wg1d/personal-autonomous-weather-station/README.md

# PAWS — Personal Autonomous Weather Station PAWS logo

Low-powered ESP32 IoT weather station — SD card logging, RTC timekeeping, direct Wi-Fi upload, phone-based fallback data gateway, time-series database, online dashboard and weather forecasting.

> 🌻 *And yes, that's a sunflower. A sunflower watches the sun. This weather station watches the weather. Close enough.*

## Documentation

Full design documentation (architecture, hardware, firmware, backend, ML) is available here: [personal-autonomous-weather-station](https://wg1d.github.io/personal-autonomous-weather-station/)

The API documentation of the firmware (`firmware/paws`), generated by Doxygen from the code comments, is published with it: [firmware API](https://wg1d.github.io/personal-autonomous-weather-station/api/)

## Development setup

All the tools (PlatformIO, Quarto, the C++ compiler, Doxygen, Python and the backend dependencies) are installed by [pixi](https://pixi.sh), with the exact versions frozen in `pixi.lock`. The CI uses the same environment, so a build that works locally works in the CI.

### 1. Install pixi

Follow the [official instructions](https://pixi.sh/latest/#installation). On Linux and macOS:

```bash
curl -fsSL https://pixi.sh/install.sh | sh
```

Then, from the root of the repository, install the environments (optional: `pixi run` also installs them on first use):

```bash
pixi install --all
```

### 2. Available commands

```bash
pixi run build-firmware   # build every PlatformIO project
pixi run test             # run the firmware tests on the computer
pixi run book             # generate the book in docs/_output
pixi run api-docs         # generate the firmware API docs in docs/_output/api
pixi run preview          # live preview of the book in the browser
pixi run dummy-server     # start the Phase 3 dummy backend server
pixi run test-server      # start the Phase 4 test server (upload v1)
pixi run backend          # start the backend on this computer (port 8080)
pixi run backend-demo     # the same, with 3 years of made-up data
pixi run backend-test     # run the backend tests
pixi run deploy-backend   # deploy the committed backend to the server
pixi run backup-backend   # make a backup of the data on the server now
pixi run restore-backend  # put back a backup on the server (optional: a day)
```

The first build downloads the ESP32 toolchain into `.pio-core/` (about 1.5 GB), inside the repository, so it does not interfere with an existing `~/.platformio`.

`pixi run api-docs` must run after `pixi run book`, since rendering the book empties `docs/_output`. It fails if a class, function or parameter of the firmware is not documented; the CI runs it on every pull request.

### 3. Flash the ESP32

Every PlatformIO command works through pixi. For example, to flash the current firmware and open the serial monitor:

```bash
pixi run pio run -d firmware/paws -t upload
pixi run pio device monitor -d firmware/paws
```

This builds the firmware of the station, with the periods of the design: one measurement every 15 minutes, one upload every hour. To see the whole cycle quickly on the bench, use the `esp32-bench` environment instead, which measures every minute and uploads every 5 minutes:

```bash
pixi run pio run -d firmware/paws -e esp32-bench -t upload
```

In VS Code with the PlatformIO extension, choose `env:esp32` or `env:esp32-bench` in the status bar.

The Proof of Concept sketches (`firmware/PoC/`) are flashed the same way, with their own folder after `-d`.

The Wi-Fi sketches read their credentials from a git-ignored `secrets.h`: copy `secrets.example.h` to `secrets.h` in the sketch folder and fill in your values. If `secrets.h` is missing, `pixi run build-firmware` creates it from the example, with placeholder values that only allow the sketch to compile.

### 4. Run the backend on the server

The backend (`backend/paws`) runs on a computer that stays on at home, as a systemd service named `paws-backend`, on port 8080. It is managed by [uv](https://docs.astral.sh/uv/), which must be installed on the server (`~/.local/bin/uv`), with SSH access from the development computer.

`pixi run deploy-backend` deploys the committed code to the SSH host `pi` (another host can be given: `bash scripts/deploy-backend.sh <host>`). It refuses to deploy changes that are not committed. On the server, the code lives in `~/paws/backend`, replaced at each deployment, and the data in `~/paws/data`, never touched by a deployment.

To stop the service, for example while the station is off, and keep it from starting again when the server boots:

```bash
ssh pi 'sudo systemctl disable --now paws-backend'
```

To start it again, now and at each boot:

```bash
ssh pi 'sudo systemctl enable --now paws-backend'
```

A deployment also starts the service, and enables it at boot. To check its state and read its messages:

```bash
ssh pi 'systemctl status paws-backend'
ssh pi 'journalctl -u paws-backend -n 50'
```

The station sends its data to the address set by `kServerUrl` in `firmware/paws/include/secrets.h`, for example `http://192.168.1.28:8080`.

### 5. Backups

Every night at 03:30, the timer `paws-backup.timer` copies the database and the log of the station, compressed, into `~/paws/data/backups` on the server, and to the cloud storage set by `PAWS_BACKUP_REMOTE` in `backend/paws/deploy/paws-backup.service` (`Proton:paws_backup` by default, a remote of [rclone](https://rclone.org/), which must be configured on the server). The last 7 days are kept on both sides. The Data tab of the dashboard shows the last backup, in red when it failed or is late.

```bash
pixi run backup-backend               # make a backup now
pixi run restore-backend              # put back the newest backup
pixi run restore-backend 2026-10-07   # put back the backup of a day
```

The restore takes the backup from the server, or from the cloud storage when the server no longer has it (a server installed again). The database it replaces is kept as `~/paws/data/measurements.db.before-restore`.

To start again from an empty database, for example to remove test data before the real station starts (this deletes the data on the server and its backups):

```bash
ssh pi 'sudo systemctl stop paws-backend && rm -f ~/paws/data/measurements.db ~/paws/data/station.log ~/paws/data/backups/* && sudo systemctl start paws-backend'
ssh pi 'rclone delete Proton:paws_backup'
```

### Environments

`pixi.toml` defines two environments:

- `default`: the development tools (PlatformIO, Quarto, C++ compiler, Doxygen);
- `backend`: Python and the backend dependencies. It is separate because PlatformIO requires an old version of `uvicorn` that recent FastAPI versions cannot use.

Each task runs in the right environment automatically.

### Not managed by pixi

Regenerating the wiring diagrams requires a LaTeX distribution with `circuitikz`, `latexmk` and `pdf2svg` (see `docs/assets/diagrams-src/Makefile`). This is only needed when a diagram changes.

## Roadmap

The primary goal of this project is to build a full, end-to-end **Proof of Concept (PoC)**, spanning from initial data collection (Phase 1) up through basic Machine Learning forecasting (Phase 6). Once this core foundation is proven, the remaining items are logged as optional future ideas to expand the station over time.

| Phase | Name | Key addition | Status |
|---|---|---|---|
| 1 | Core Functionality | Temp/pressure/humidity sensor + SD logging + RTC timekeeping | 🟢 Done |
| 2 | Power Management | ESP32 deep sleep + peripheral power cycling + RTC alarms | 🟢 Done |
| 3 | Wi-Fi & Data Transmission | ESP32 automated Wi-Fi push + phone-based gateway fallback | 🟢 Done |
| 4 | Firmware Architecture | State machine design + modular firmware rewrite with host tests | 🟢 Done |
| 5 | Backend MVP | SBC deployment + time-series database + online dashboard | 🟡 In progress |
| 6 | Forecasting — basic | LSTM on temp/pressure/humidity | ⬜ Planned |
| 7 | Sensors: BH1750 + VEML6075 | Light + UV sensors | 💭 Idea |
| 8 | Sensor: Soil moisture | Capacitive sensor | 💭 Idea |
| 9 | Sensor: Rain gauge | Tipping bucket | 💭 Idea |
| 10 | Sensor: Wind | Anemometer + wind vane | 💭 Idea |
| 11 | Model retrain + watering | Expanded LSTM + Random Forest watering model | 💭 Idea |
| 12 | Power: Solar + battery | Solar panel + battery monitoring | 💭 Idea |
| 13 | Stevenson screen + outdoor deployment | Final assembly into a Stevenson screen | 💭 Idea |

## Related projects

- [3D-PAWS](https://3dpaws.comet.ucar.edu/) (UCAR/COMET) — *3D-Printed Automatic Weather Station*: An open-source, low-cost weather station with 3D-printed sensor housings.

## License

MIT — see [LICENSE](LICENSE)
