wg1d/personal-autonomous-weather-station/docs/chapters/Architecture/Phase-04/00-3-data-and-upload.qmd

# Data and Upload {.unnumbered}

This chapter describes the row stored by `STORE` at each wake-up, and the protocol used by `UPLOAD` to send the rows to the server (see the [state machine](00-2-behavior.qmd#state-machine)).

## Data Format (v1)

Measurements are appended to `/measurements_v1.csv`, one row per wake-up:

```csv
timestamp,time_valid,temperature_c,humidity_pct,pressure_hpa
2026-10-01T14:15:00Z,1,18.42,62.10,1013.20
2026-10-01T14:30:00Z,1,18.37,,1013.18
```

| Column | Content | Unit |
|---|---|---|
| `timestamp` | Date and time of the measurement | ISO 8601, UTC, with the explicit `Z` suffix |
| `time_valid` | `1` if the clock was reliable when the row was written, `0` otherwise (F6 · Flag unreliable time) | — |
| `temperature_c` | Air temperature | degrees Celsius (°C) |
| `humidity_pct` | Relative humidity | percent (%) |
| `pressure_hpa` | Atmospheric pressure | hectopascals (hPa) |

The suffix of each measurement column gives its unit (`_c`, `_pct`, `_hpa`), so the file can be read without this table. The second row of the example shows a missing humidity value: an empty field.

A row is about 50 bytes: 96 rows per day represent about 5 KB per day, less than 2 MB per year.

When new sensors are added, the file format changes: the firmware then writes to a new file (`measurements_v2.csv`) with the new columns. A file never mixes two formats.

## Upload Protocol {#upload-protocol}

The PoC sent the whole CSV file at every upload, and the dummy server overwrote its copy each time. This protocol replaces it with three goals: send only the new rows, never lose data (N1), and survive an interruption at any moment. It is also the **contract with the Phase 5 backend**.

### The upload cursor

The station remembers where the server's copy ends with an **upload cursor**: the position, in bytes, of the first row of `/measurements_v1.csv` that the server has not acknowledged yet. It is stored in the small file `/upload.idx` on the SD card, so it survives power losses.

We use a position in bytes rather than a row number because the SD adapter can then jump directly to it (`file.seek()`), without reading the whole file. The cursor always points to the beginning of a row.

### Request

The station sends the rows after the cursor, preceded by the header line, so that each request is self-describing:

```http
POST /api/v1/measurements HTTP/1.1
Host: 192.168.1.15:8080
Content-Type: text/csv

timestamp,time_valid,temperature_c,humidity_pct,pressure_hpa
2026-10-01T13:15:00Z,1,18.20,63.40,1013.35
2026-10-01T13:30:00Z,1,18.31,62.90,1013.28
2026-10-01T13:45:00Z,1,18.35,62.50,1013.22
2026-10-01T14:00:00Z,1,18.40,62.20,1013.21
```

A request contains at most **500 rows** (about 25 KB). This bounds the duration of each request and the memory needed on the server. In normal operation, an upload contains 4 rows. After a week without Wi-Fi, the 672 missing rows are sent in two requests.

### Response

The server stores the rows and **ignores rows whose timestamp already exists**. It answers with a `2xx` status code and a short JSON summary:

```json
{"received": 4, "inserted": 4, "duplicates": 0}
```

The station only relies on the status code. The summary is printed on the serial port, which helps debugging.

### Sequence

```{mermaid}
sequenceDiagram
    participant S as Station
    participant SD as SD card
    participant B as Backend
    S->>SD: Read the cursor and the next rows (at most 500)
    S->>B: POST /api/v1/measurements (header + rows)
    B-->>S: 200 OK {"received": 500, ...}
    S->>SD: Move the cursor after the sent rows
    S->>SD: Read the next rows
    S->>B: POST /api/v1/measurements (header + rows)
    B-->>S: 200 OK {"received": 172, ...}
    S->>SD: Move the cursor after the sent rows
    Note over S,SD: No rows left: the upload is complete
```

### Failure cases

The protocol relies on two rules: **the cursor only moves forward after a `2xx` response**, and **the server accepts duplicates without error**. Together, they cover every interruption:

| What happens | Result |
|---|---|
| The Wi-Fi connection fails | Nothing is sent; the cursor does not move; retry at the next full hour. |
| The server answers with an error (not `2xx`) | The cursor does not move; the same rows are sent at the next upload. |
| The server stores the rows, but the response is lost (timeout, Wi-Fi drop) | The cursor does not move; the rows are sent again at the next upload, and the server ignores them as duplicates. |
| Power loss after the response, before the cursor is written | Same as a lost response: the rows are sent again and ignored. |
| `/upload.idx` is lost or unreadable | The cursor restarts at the beginning of the file: everything is sent again, and the server ignores the duplicates. |

In every case, the rows remain on the SD card, and the server never stores a row twice in its database. This property, where repeating a request has the same effect as sending it once, is called **idempotence**.

One case is not solved automatically: if the server keeps rejecting the same batch (for example because of a malformed row caused by a bug), the uploads are blocked. The data is still safe on the SD card, and the problem is visible on the dashboard, since no new data arrives.

### Scope

The protocol uses plain HTTP on the home network, without authentication, consistent with the single-user scope defined in [Motivation & Goals](../../01-motivation.qmd). It would need encryption (HTTPS) and authentication if the server were ever exposed to the internet.

The [next chapter](00-4-structure-and-verification.qmd) describes how the code is organized, and how we check that it meets the requirements.
