wg1d/personal-autonomous-weather-station/docs/index.qmd

# Introduction {.unnumbered}

PAWS logo

**PAWS** (*Personal Autonomous Weather Station*) is a low-powered ESP32 weather station with SD card logging, RTC timekeeping, direct Wi-Fi data transfer (and a phone-based data gateway as fallback), time-series database, online dashboard, plant watering decisions, and local weather forecasting on a Single-Board Computer like a Raspberry Pi.

It's a learning-oriented project covering several topics, such as:

- Embedded firmware based on Arduino code
- Weather data collection
- Solar-powered systems
- Data transfer & time-series databases
- Web dashboards
- Machine learning

::: {.callout-note}
**Related project — 3D-PAWS** (*3D-Printed Automatic Weather Station*, UCAR/COMET): an open-source initiative for low-cost weather stations using 3D-printed sensor housings. Their sensor designs (tipping bucket rain gauge, anemometer) are a useful reference for the DIY hardware phases of this project. See [3dpaws.comet.ucar.edu](https://3dpaws.comet.ucar.edu/).
:::

### Target Audience & Scope
> This project focuses on system integration, software architecture, and power management. It is **not** a beginner tutorial on how to install the Arduino IDE, how to solder, or how to write basic ESP32 blink sketches. It assumes you already know how to compile and upload code to an ESP32.

### Resources for Beginners
If you are new to the ESP32 ecosystem, we recommend reading the following tutorials before starting this weather station:

- **[uPesy Documentation](https://www.upesy.fr/blogs/tutorials/esp32-tutorials-for-arduino-code-and-micropython)**: clear, well-illustrated tutorials covering most ESP32 topics.
- **[Random Nerd Tutorials](https://randomnerdtutorials.com/)**: a large collection of beginner-friendly ESP32 projects and electronics guides.

---

## How to read this document

| Goal | Chapter |
|---|---|
| Understand *why* this project exists | [Motivation & Goals](chapters/01-motivation.qmd) |
| Understand *how* the project evolves | [Roadmap](chapters/02-roadmap.qmd) |
| Start building the prototype | [Start Building Now 🚀](chapters/PoC/Phase-01/01-components.qmd)|

---
