wg1d/personal-autonomous-weather-station/docs/chapters/02-roadmap.qmd

# Roadmap {.unnumbered}

Building a weather station from scratch can be overwhelming. To keep the learning curve manageable, this project is divided into two journeys: the **Proof of Concept (PoC)**, which builds each feature with simple sketches, and the **Production Architecture**, which rebuilds the firmware on a clean, tested structure.

## Journey 1: The Proof of Concept (Phases 1-3)

The goal of the PoC is to get every feature working as simply as possible, to understand how the hardware behaves. We write plain `.ino` sketches, adding one feature at a time. By the end of this journey, you will have a working weather station that reads sensors, sleeps, and uploads data over Wi-Fi, without any advanced C++.

*   **Phase 1: Core Functionality**
    We start with a breadboard and a USB cable. We will wire the ESP32 to a temperature/humidity sensor, an SD card, and an RTC, writing simple scripts to log data.
*   **Phase 2: Power Management**
    Once the baseline works, we introduce ESP32 deep sleep and RTC alarms, the foundation for running on batteries.
*   **Phase 3: Wi-Fi & Data Transmission**
    Finally, we connect the station to Wi-Fi to push data to a local dummy server, add a manual download fallback, and synchronize the clock with NTP. This completes the end-to-end PoC.

## Journey 2: The Production Architecture (Phase 4)

Once you understand *how* the hardware works from the PoC, we rebuild the firmware properly. Experienced developers can start directly with this phase, but the PoC chapters remain the reference for wiring and hardware behavior.

*   **Phase 4: Modular Architecture**
    The PoC sketches grew into long, monolithic files that are hard to test and extend. We design the architecture on paper first (requirements, state machine, module interfaces, data format), then rebuild the firmware from scratch as a single PlatformIO project, step by step, with unit tests running on the host computer.

## Beyond Firmware (Phases 5+)

Once the production firmware is reliable, we shift our focus away from the ESP32.

*   **Phase 5: Backend MVP**
    We deploy a server on a small computer that stays on at home, with a database, a dashboard and a daily backup, to replace our test server.
*   **Phase 6: Outdoor Station**
    The station leaves the breadboard and the desk: a soldered board, a weatherproof enclosure, a radiation shield (a Stevenson screen) so that the sun does not heat the sensor, a Wi-Fi link that reaches the garden, and its own power: a battery charged by a small solar panel, since there is no socket outdoors, with its charge measured and sent with the data.
*   **Phase 7: Data Collection**
    The station runs outdoors for months. We watch how reliable it is: its power through the seasons, short winter days included, the failures, the values that make no sense.
*   **Phase 8: Basic Forecasting**
    With months of real measurements, we introduce basic Machine Learning (LSTM) to predict weather trends. A forecast can only learn from the data it is given: this is why the station goes outdoors first.

---

# Future Expansions (Ideas) {.unnumbered}

While Phases 1 through 8 represent the core project (from data collection to forecasting), the following sections are purely optional ideas to expand the station's capabilities if we decide to take it further.

## A Single Definition of the Data Format (Idea)
The CSV format of the measurements is written twice: in C++ in the firmware, which writes the rows, and in Python in the backend, which reads them. A single reference file could describe the columns (name, type, unit), and a small script could generate the code of both sides from it, so that they can never disagree. This becomes more useful as new sensors add columns to the format.

## Adding Light & UV Sensors (Idea)
Once we validate that the system is working fine (data acquisition, storage, data transfer, and basic ML), let's improve the station by adding some new sensors. Let's start by adding a light and UV sensor to the station like the BH1750 and the VEML6075.

## Adding Soil Moisture Sensor (Idea)
After that, we can add a soil moisture sensor (such as the ubiquitous Capacitive Soil Moisture Sensor v1.2 or v2.0) to the station in order to determine if plants need to be watered.

## Adding a Rain Gauge (Idea)
Adding a tipping bucket rain gauge sensor to measure rainfall would be a good improvement to the station. The 3D-PAWS project has a good example of a 3D-printed tipping bucket rain gauge.

## Adding an Anemometer (Idea)
Adding an anemometer and wind vane to measure wind speed and direction would be a good addition to the station. The 3D-PAWS project also has a good example of a 3D-printed anemometer and wind vane.

## Advanced ML & Watering (Idea)
With all sensors active, we will retrain our ML models and add a Random Forest model specifically to optimize the watering schedule of the plants based on the new local data.
