wg1d/personal-autonomous-weather-station/docs/chapters/01-motivation.qmd

# Motivation & Goals {.unnumbered}

---

## What this project is really about

This is a **personal learning project** with a clear, hands-on goal: understand how a weather station works end-to-end, from raw sensor reading to a usable dashboard and simple predictive models.

The motivating use case is intentionally concrete and minimalistic:

> *Knowing when it actually makes sense to water outdoor plants, based on observed local conditions.*

The project is **not** intended to compete with commercial stations, replace a professional meteorological network, or solve large-scale climate problems. It is intended to be educational, achievable, and progressively useful.

---

## Goals

The project has three layers of goals, ordered by priority:

### Layer 1 — Hardware & firmware (core)

- Build a reliable, low-power data logger from scratch
- Understand sensor data acquisition, embedded timekeeping, and deep-sleep power management of an ESP32 microcontroller
- Produce consistent, timestamped, locally-stored data

### Layer 2 — Data pipeline

- Understand how to move data from a field device with intermittent Wi-Fi access to a server
- Build a simple backend (ingestion, storage, dashboard) hosted locally on a Raspberry Pi

### Layer 3 — Local intelligence

- Use collected data for practical decisions (plant watering)
- Explore short-term weather forecasting using machine learning on local sensor data

---

## Scope and constraints

The project explicitly accepts the following constraints:

| Constraint | Rationale |
|---|---|
| Single station | Manageable scope for a personal project |
| Single user | No multi-user, permissions, or security requirements |
| No permanent internet connection at the station | Enables solar/battery operation, the station connects to Wi-Fi only to upload data, remaining offline during measurement and deep sleep |
| Incremental approach | Each phase must be independently useful |

---

## Day-to-day operation

In typical operation, data transmission would be fully automated. However, a local fallback mode will be developed for offline environments or testing purposes (manual data transfer using a phone as gateway):

1. **Automated Upload (Primary)**: The station wakes up on its schedule, reads the sensors, appends the data to the local SD card, and attempts to connect to the home Wi-Fi network. If successful, it uploads the latest readings directly to the server API and returns to deep sleep. If the home Wi-Fi is out of range or unavailable, it directly goes to deep sleep, leaving the data safely buffered on the SD card.
2. **Manual Download Gateway (Fallback)**: When deployed out of range (or for testing purposes), the user can press a button. This wakes the ESP32 and puts it in `SERVER` mode, spinning up a local Wi-Fi Access Point for 3 minutes. The user connects their phone, downloads the data via a browser, and later uploads it to the backend server. The station automatically returns to deep sleep after the 3-minute timeout.

---

## Build philosophy

Each phase of this project must be **independently useful**: you can stop at any phase and have a working system. The hardware built in one phase is reused in the next ones. The PoC firmware is a learning step: it is deliberately rewritten in Phase 4, once we understand the hardware well enough to design a clean architecture.

---

## What this project is NOT

- A commercial product
- A real-time alerting system
- A replacement for a professional weather API
- A multi-node sensor network

These are all compatible with the architecture but are explicitly out of scope.
