wg1d/personal-autonomous-weather-station/docs/chapters/03-prototyping.qmd

# Incremental Prototyping Guide {.unnumbered}

To ensure a robust and debuggable build, the station is developed **incrementally**. Instead of building the entire system at once, you will assemble and validate it step-by-step on a breadboard. This approach makes it easy to isolate hardware defects (like bad jumper wires or faulty modules) from software bugs.

This chapter walks through the **8 prototyping milestones**. Each milestone includes the necessary wiring diagrams in ASCII, links to the complete Arduino example code, and instructions for verifying that it works.

---

## ESP32 Breadboard Pin Mapping

To ensure you can reuse your existing breadboard configuration without rewiring, we align all code with the pin connections established in your project:

| Module / Component | ESP32 Pin | Function | Description |
| :--- | :--- | :--- | :--- |
| **DS3231 RTC** | GPIO 21 | `SDA` (I²C Data) | Shared I²C communication line |
| | GPIO 22 | `SCL` (I²C Clock) | Shared I²C clock line |
| | **GPIO 36** (`VP`) | `SQW / INT` | RTC Alarm output; wakes ESP32 from sleep via `EXT0` |
| **BME280 Sensor** | GPIO 21 | `SDA` (I²C Data) | Shared I²C communication line |
| | GPIO 22 | `SCL` (I²C Clock) | Shared I²C clock line |
| **SD Card Reader** | GPIO 5 | `CS` (Chip Select) | Dedicated SPI Select line |
| | GPIO 18 | `SCK` (Serial Clock) | Shared SPI Clock line |
| | GPIO 19 | `MISO` | Shared SPI Master In Slave Out line |
| | GPIO 23 | `MOSI` | Shared SPI Master Out Slave In line |
| | **GPIO 13** | `Power Gate` | Controlled VCC supply to cut power to the SD reader during sleep |
| **Manual Button** | **GPIO 39** (`VN`) | `Switch Trigger` | Manual trigger for AP mode; wakes ESP32 via `EXT1` |

---

## Step 1: Button & LED (Pull-Up/Pull-Down Resistor Physics)

The first step is to verify digital inputs/outputs and understand the physical properties of input pins. 

### The Physics: Floating Pins & Pull-Up Resistors
When an ESP32 GPIO pin is configured as an input, it is in a "high-impedance" state. If it is not connected to a reference voltage, it is **floating**. Electromagnetic noise from the air or nearby AC lines will cause the pin to randomly fluctuate between `HIGH` (3.3V) and `LOW` (0V).

To prevent this, we connect the input pin to a known voltage level using a resistor:
*   **Pull-Up Resistor (Active-Low):** Connects the input pin to `3.3V`. The pin reads `HIGH` by default. Pressing the button connects the pin to `GND`, making it read `LOW`.
*   **Pull-Down Resistor (Active-High):** Connects the input pin to `GND`. The pin reads `LOW` by default. Pressing the button connects the pin to `3.3V`, making it read `HIGH`.

Active-low (using pull-up resistors) is the industry standard for microcontrollers. If a ground wire shorts to a metal frame, it's harmless; if a VCC wire shorts, it causes a short circuit.

::: {.callout-note}
### Can I just use the ESP32's internal pull-up resistors?
Yes! The ESP32 actually does allow you to enable its internal pull-up/pull-down resistors during deep sleep, provided you use the RTC-specific control functions (e.g., `rtc_gpio_pullup_en(GPIO_NUM_39)`). If you do this, you can omit the external resistor from your breadboard.

However, using a **physical external resistor** (like the $10\text{ k}\Omega$ or $100\text{ k}\Omega$ you set up) remains the recommended best practice for two main reasons:
* **Lower Power Consumption:** The internal RTC resistors are fixed at roughly $45\text{ k}\Omega$. While a button is pressed, the current flowing to GND is $3.3\text{V} / 45\text{ k}\Omega = 73\text{ }\mu\text{A}$. If you use a physical external $100\text{ k}\Omega$ pull-up resistor, this current is cut in half to just $33\text{ }\mu\text{A}$.
* **Noise Immunity & Stability:** Internal resistors are transistor-based and can drift with temperature and manufacturing tolerances. Physical discrete resistors are highly stable and far more effective at preventing false wakeups caused by electromagnetic noise in long sensor wires.
:::

#### The Resistor Equation
The value of the resistor $R$ must be selected such that when the switch is open, the voltage at the input pin ($V_{pin}$) remains well within the threshold for a stable logic state, despite the tiny input leakage current ($I_{leak}$) flowing into or out of the pin.

For a pull-up resistor:
$$V_{pin} = V_{dd} - (I_{leak} \times R)$$

To guarantee the ESP32 registers a logic `HIGH`, $V_{pin}$ must stay above the minimum high-level input voltage ($V_{IH}$). For the ESP32 running at $V_{dd} = 3.3\text{V}$, $V_{IH} = 0.75 \times V_{dd} = 2.475\text{V}$. The input leakage current is typically $I_{leak} = 1\text{ }\mu\text{A}$ maximum.

Rearranging the formula to solve for the maximum allowable resistance $R_{pu}$:
$$R_{pu} \le \frac{V_{dd} - V_{IH}}{I_{leak}}$$
$$R_{pu} \le \frac{3.3\text{V} - 2.475\text{V}}{10^{-6}\text{A}} = 825\text{ k}\Omega$$

While any resistor under $825\text{ k}\Omega$ works in theory, standard practice is to use a **$10\text{ k}\Omega$** or **$47\text{ k}\Omega$** resistor. 
*   **Why not use the maximum ($825\text{ k}\Omega$)?** High resistance leaves the pin susceptible to electromagnetic interference (noise), which can cause false wakeups.
*   **Why not use very low resistance (e.g. $1\text{ k}\Omega$)?** When the button is pressed, a current path is created from $V_{dd}$ to `GND`. The current is $I = V_{dd} / R$. A $1\text{ k}\Omega$ resistor draws $3.3\text{ mA}$ while pressed. A $10\text{ k}\Omega$ resistor drops that draw to $0.33\text{ mA}$ ($330\text{ }\mu\text{A}$), protecting the battery during manual button presses.

### Wiring Schematic (ASCII)

```
             +3.3V (VCC)
                 |
               [10k Ohm Resistor]
                 |
  GPIO 39 -------+------[ Button ]------ GND
  
  GPIO 2  -------[ LED ]---[ 220 Ohm ]-- GND
```

### Prototyping Code
The code for this step is located in [01_button_led.ino](file:///home/william/Documents/personal-autonomous-weather-station/firmware/prototyping/01_button_led/01_button_led.ino). It polls the button on GPIO 39 and reflects the state on the blue onboard LED (GPIO 2).

### Verification
1. Upload [01_button_led.ino](file:///home/william/Documents/personal-autonomous-weather-station/firmware/prototyping/01_button_led/01_button_led.ino).
2. Open the Serial Monitor at `115200` baud.
3. Verify that pressing the button logs `Button Pressed (LOW) -> LED ON` and lights the blue LED.
4. Releasing the button logs `Button Released (HIGH) -> LED OFF` and turns off the LED.

---

## Step 2: Button Wakeup (Deep Sleep & EXT1)

To run on batteries, the ESP32 must spend most of its time in **Deep Sleep**. In this mode, the main CPU and RAM are powered down. Only the ultra-low-power RTC (Real-Time Clock) controller remains active.

### Concept: State Retention & EXT1 Wakeup
Since main RAM is cleared when the ESP32 sleeps, **every wakeup is a fresh boot**. To preserve variables (such as a boot counter) across sleep cycles, we use the `RTC_DATA_ATTR` modifier. This forces the compiler to place the variable in the RTC's slow memory.

To wake up the ESP32 via a button press, we configure the **`EXT1`** wakeup controller. `EXT1` monitors a list of pins and triggers a boot when they go `LOW` (active-low configuration).

### Wiring Schematic (ASCII)
Same as Step 1 (the button connects GPIO 39 to GND via a pull-up resistor).

### Prototyping Code
The code is located in [02_button_wakeup.ino](file:///home/william/Documents/personal-autonomous-weather-station/firmware/prototyping/02_button_wakeup/02_button_wakeup.ino).

### Verification
1. Upload [02_button_wakeup.ino](file:///home/william/Documents/personal-autonomous-weather-station/firmware/prototyping/02_button_wakeup/02_button_wakeup.ino).
2. Open the Serial Monitor. Press `EN` (Reset) on the board. You should see `Boot number: 1` and `Wakeup not caused by deep sleep`.
3. The board goes to sleep and the LED turns off.
4. Press the button. The ESP32 boots instantly, turns on the LED for 2 seconds, and prints:
   * `Boot number: 2`
   * `Wakeup caused by external signal using RTC_CNTL (EXT1 - Button on GPIO 39)`

---

## Step 3: Temperature/Humidity/Pressure Sensor (BME280)

We introduce the **BME280** sensor to read environmental conditions over the **I²C** bus.

### Concept: The I²C Bus
The I²C bus uses only two shared wires to talk to multiple devices:
*   **SDA (Serial Data Line):** Carries the data.
*   **SCL (Serial Clock Line):** Synchronizes the data transfer.

During Deep Sleep, the BME280 sensor enters standby automatically when the ESP32 stops communication. In this standby mode, it draws a negligible current of **0.1 µA**, meaning it does not need physical power gating.

### Wiring Schematic (ASCII)

```
                 ESP32
             +-----------+
             |           |
             |  GPIO 21  |<====> SDA (BME280 SDA)
             |  GPIO 22  |=====> SCL (BME280 SCL)
             |  3.3V     |-----> VCC (BME280 VCC)
             |  GND      |-----> GND (BME280 GND)
             +-----------+
```

### Prototyping Code
The code is located in [03_temp_humidity_sensor.ino](file:///home/william/Documents/personal-autonomous-weather-station/firmware/prototyping/03_temp_humidity_sensor/03_temp_humidity_sensor.ino).

### Verification
1. Upload [03_temp_humidity_sensor.ino](file:///home/william/Documents/personal-autonomous-weather-station/firmware/prototyping/03_temp_humidity_sensor/03_temp_humidity_sensor.ino).
2. The Serial Monitor will print environmental values every 5 seconds.
3. Blow gently on the sensor to confirm that the humidity and temperature readings update dynamically.

---

## Step 4: Real-Time Clock & Alarms (DS3231)

To wake up the station periodically (e.g. every 10 minutes) at exact intervals, we use a temperature-compensated **DS3231 RTC**.

### Concept: EXT0 Wakeup
The DS3231 maintains accurate time and can trigger its `SQW/INT` alarm pin. 
*   We connect this pin to **GPIO 36** on the ESP32.
*   The SQW pin is active-low (goes to 0V when an alarm fires).
*   Since GPIO 36 is an input-only pin without internal pull-ups, we must connect a physical **10k Ohm external pull-up** resistor between GPIO 36 and 3.3V.
*   We configure the ESP32 to wake up on **`EXT0`** (which monitors a single RTC pin and wakes the chip when the pin goes `LOW`).

### Wiring Schematic (ASCII)

```
                   +3.3V (VCC)
                       |
                     [10k Ohm]
                       |
  GPIO 36 -------------+------------ SQW/INT (DS3231)
  
  GPIO 21 <========================> SDA (DS3231 SDA) [Shared I2C]
  GPIO 22 =========================> SCL (DS3231 SCL) [Shared I2C]
```

### Prototyping Code
The code is located in [04_real_time_clock.ino](file:///home/william/Documents/personal-autonomous-weather-station/firmware/prototyping/04_real_time_clock/04_real_time_clock.ino).

### Verification
1. Upload [04_real_time_clock.ino](file:///home/william/Documents/personal-autonomous-weather-station/firmware/prototyping/04_real_time_clock/04_real_time_clock.ino).
2. The ESP32 sets the alarm to trigger at the beginning of the next minute and goes to sleep.
3. When the RTC alarm fires, the ESP32 boots and reports `Wakeup caused by external RTC Alarm (EXT0 on GPIO 36)`.

---

## Step 5: SD Card CSV Logger & Power Gating

Writing measurements to an SD card is critical for data buffering. However, SD card modules draw up to **2 mA** when idle, which would deplete the battery in a few weeks.

### Concept: Power Gating
To eliminate standby current, we connect the SD card reader's power line (`VCC`) to **GPIO 13** (acting as a high-side switch). 
*   **Active State:** We drive GPIO 13 `HIGH` to supply 3.3V to the reader, wait 100ms for voltage stability, and initialize the card.
*   **Sleep State:** We unmount the SD card via software (`SD.end()`) and drive GPIO 13 `LOW` to cut off power completely before entering deep sleep.

### Wiring Schematic (ASCII)

```
             ESP32
         +-----------+
         |  GPIO 13  |----------> VCC (SD Card VCC) [Power Gate]
         |  GPIO 5   |----------> CS  (SD Card Chip Select)
         |  GPIO 23  |----------> MOSI (SD Card MOSI)
         |  GPIO 19  |<---------- MISO (SD Card MISO)
         |  GPIO 18  |----------> SCK  (SD Card Clock)
         |  GND      |----------> GND  (SD Card GND)
         +-----------+
```

### Prototyping Code
The code is located in [05_sd_card_logger.ino](file:///home/william/Documents/personal-autonomous-weather-station/firmware/prototyping/05_sd_card_logger/05_sd_card_logger.ino).

### Verification
1. Insert a FAT32-formatted MicroSD card into the reader.
2. Upload [05_sd_card_logger.ino](file:///home/william/Documents/personal-autonomous-weather-station/firmware/prototyping/05_sd_card_logger/05_sd_card_logger.ino).
3. The Serial Monitor should show that the SD card powers up, mounts, appends a mock CSV line, displays the total file content, and powers off.
4. The ESP32 sleeps for 10 seconds and repeats the cycle.

---

## Step 6: Integrated Offline Datalogger

We now integrate all the previous components into a single offline datalogger loop.

### Operations Flow
```
        [ Boot / Wakeup ]
                |
     Determine Wakeup Cause
      /                  \
   (RTC)               (Button)
    /                      \
Read BME280 Sensors     Read BME280 Sensors
    \                      /
   Power Gate ON SD Card
   Append Log to data.csv
   Power Gate OFF SD Card
                |
     Schedule next RTC Alarm
   Enable EXT0 (RTC) & EXT1 (Button)
                |
        [ Deep Sleep ]
```

### Prototyping Code
The code is located in [06_full_datalogger.ino](file:///home/william/Documents/personal-autonomous-weather-station/firmware/prototyping/06_full_datalogger/06_full_datalogger.ino).

### Verification
1. Upload [06_full_datalogger.ino](file:///home/william/Documents/personal-autonomous-weather-station/firmware/prototyping/06_full_datalogger/06_full_datalogger.ino).
2. The board logs readings to `/data.csv` every minute.
3. Pressing the manual button at any time will trigger an immediate measurement cycle.

---

## Step 7: Wi-Fi Access Point & Server Mode

When the weather station is deployed outdoors, we need a wireless method to download the CSV data.

### Concept: Manual AP Activation
If the ESP32 is woken up by the manual button (detected via `EXT1`), it enters AP Mode instead of taking a periodic reading.
*   It spins up an Access Point called `PAWS-Station` with password `password123`.
*   It starts an HTTP Web Server on port 80.
*   The web page displays a list of files on the SD card with download links.
*   A **3-minute inactivity timer** is tracked. If the user does not query the server, the ESP32 automatically shuts down the AP, powers off the SD card, and goes back to deep sleep to protect the battery.

### Prototyping Code
The code is located in [07_wifi_ap.ino](file:///home/william/Documents/personal-autonomous-weather-station/firmware/prototyping/07_wifi_ap/07_wifi_ap.ino).

### Verification
1. Upload [07_wifi_ap.ino](file:///home/william/Documents/personal-autonomous-weather-station/firmware/prototyping/07_wifi_ap/07_wifi_ap.ino).
2. Connect your phone or PC to the `PAWS-Station` Wi-Fi network.
3. Open a browser and navigate to `http://192.168.4.1`.
4. Click on `data.csv` to download the logged data directly to your device.
5. Wait 3 minutes without action; the station should print `Inactivity timeout reached` and go to sleep.

---

## Step 8: Wi-Fi Client & Linux Server Integration

Finally, we test automatic synchronization where the ESP32 acts as a client that connects to your home network and uploads the data to your Linux host.

### Concept: Automated Upload
*   The ESP32 connects to your home Wi-Fi.
*   It reads the raw contents of `/data.csv` from the SD card.
*   It issues an HTTP `POST` request to `http://<LINUX_IP>:8000/api/upload`.
*   A simple Python script runs on the Linux host to save the incoming CSV stream.

### 1. Python Server Script (Linux Host)
Save this script as `server.py` on your Linux host and execute it:
```python
import http.server
import socketserver
import os

PORT = 8000
LOG_FILE = "paws_log_sink.csv"

class DataSinkHandler(http.server.SimpleHTTPRequestHandler):
    def do_POST(self):
        if self.path == "/api/upload":
            length = int(self.headers['Content-Length'])
            raw_data = self.rfile.read(length)
            
            print(f"\n[+] Incoming upload of {length} bytes received.")
            try:
                decoded = raw_data.decode('utf-8')
                with open(LOG_FILE, "w") as f:
                    f.write(decoded)
                print(f"[+] Saved successfully to: {os.path.abspath(LOG_FILE)}")
                
                self.send_response(200)
                self.send_header('Content-Type', 'text/plain')
                self.end_headers()
                self.wfile.write(b"Success")
            except Exception as e:
                print(f"[-] Write error: {e}")
                self.send_response(500)
                self.end_headers()
        else:
            self.send_response(404)
            self.end_headers()

if __name__ == "__main__":
    with socketserver.TCPServer(("", PORT), DataSinkHandler) as server:
        print(f"[*] Linux Receiver online on port {PORT}...")
        try:
            server.serve_forever()
        except KeyboardInterrupt:
            print("\n[-] Server closed.")
```

### Prototyping Code
The code is located in [08_wifi_client.ino](file:///home/william/Documents/personal-autonomous-weather-station/firmware/prototyping/08_wifi_client/08_wifi_client.ino). Make sure to configure the `ssid`, `password`, and `serverIP` variables inside the code before uploading.

### Verification
1. Run `python3 server.py` on your Linux terminal.
2. Edit the Wi-Fi credentials and local Linux IP in [08_wifi_client.ino](file:///home/william/Documents/personal-autonomous-weather-station/firmware/prototyping/08_wifi_client/08_wifi_client.ino) and upload it.
3. Check the Python terminal on the Linux host; it should print `Incoming upload of X bytes received` and create the `paws_log_sink.csv` file.
