wg1d/personal-autonomous-weather-station/docs/chapters/Appendix/01-pull-resistors.qmd

# Pull-Up and Pull-Down Resistors {.unnumbered}

A button, an alarm output or an enable pin is connected to an input of the microcontroller through a resistor that gives the input a defined state when nothing drives it. This appendix explains the two ways to connect this resistor, computes what happens in each case, and gives the rules to choose between them. The [Hardware Changes](../PoC/Phase-02/02-hardware-modifications.qmd) and [Fallback AP](../PoC/Phase-03/03-fallback-ap.qmd) chapters apply them.

## A floating pin
A pin that is not connected to anything is "floating": it picks up electrical noise and randomly reads `HIGH` (1) or `LOW` (0). A resistor gives the pin a defined default state when the button is not pressed:

- **Pull-up Resistor:** connects the pin to `3.3V`. The default state is `HIGH`; pressing the button connects the pin to `GND`, driving it `LOW`.
- **Pull-down Resistor:** connects the pin to `GND`. The default state is `LOW`; pressing the button connects the pin to `3.3V`, driving it `HIGH`.

::: {layout-ncol=2}
Pull-up, button released: the pin reads HIGH

Pull-up, button pressed: the pin reads LOW

Pull-down, button released: the pin reads LOW

Pull-down, button pressed: the pin reads HIGH
:::

In both cases, no current flows through the resistor while the button is released, since both ends are at the same voltage. The consumption during deep sleep is therefore the same.

## The Equations Behind the Diagrams
The button and the resistor are connected **in series** between 3.3V and GND. An ESP32 input draws almost no current (at most 50 nA according to the ESP32 datasheet), so the same current $I$ flows through the button and the resistor. Two laws are enough to compute everything:

- **Ohm's law** for the resistor: $U_R = R \times I$
- **The voltages add up** along the series path: $V_{CC} = U_R + U_{button}$

**Button released (open).** No current can flow through an open contact:

$$I = 0 \quad\Rightarrow\quad U_R = R \times 0 = 0\,V$$

- Pull-up: the pin sees $V_{CC}$ through the resistor, $V_{in} = V_{CC} - U_R = 3.3\,V$: logic **HIGH**.
- Pull-down: the pin sees GND through the resistor, $V_{in} = U_R = 0\,V$: logic **LOW**.

**Button pressed (closed).** The closed contact has almost no resistance, so it connects the pin directly to GND (pull-up) or to $V_{CC}$ (pull-down). All the voltage is then across the resistor:

$$U_R = V_{CC} = 3.3\,V \qquad I = \frac{V_{CC}}{R} = \frac{3.3\,V}{10\,k\Omega} = 0.33\,mA$$

- Pull-up: $V_{in} = 0\,V$: logic **LOW**.
- Pull-down: $V_{in} = V_{CC} = 3.3\,V$: logic **HIGH**.

**The leakage current sets the maximum resistance.** In reality, the pin draws a tiny current $I_{leak}$ (up to 50 nA). With a pull-up and the button released, this current flows through the resistor and lowers the pin voltage:

$$V_{in} = V_{CC} - R \times I_{leak}$$

With 10kΩ, the drop is only $10\,k\Omega \times 50\,nA = 0.5\,mV$. The pin is read as HIGH as long as $V_{in}$ stays above $V_{IH} = 0.75 \times V_{CC} = 2.475\,V$ (ESP32 datasheet), which gives an upper limit for $R$:

$$R_{max} = \frac{V_{CC} - V_{IH}}{I_{leak}} = \frac{3.3\,V - 2.475\,V}{50\,nA} \approx 16\,M\Omega$$

The same reasoning applies to a pull-down, with the LOW threshold $V_{IL} = 0.25 \times V_{CC}$. This theoretical limit is very high: in practice, a very large resistor also lets electrical noise move the pin voltage, which is why values between 10kΩ and 100kΩ are used. For comparison, the ESP32 internal pull-up and pull-down resistors are about 45kΩ (not available on GPIOs 34 to 39).

## Which One to Choose?
Both configurations work electrically. The choice depends on three questions, in this order:

1. **What can the other side of the line do?** Many chip outputs are *open-drain*: they can only pull the line LOW, never drive it HIGH. This is the case of the I2C bus and of the DS3231 `SQW` pin. For these signals there is no choice: a **pull-up** is mandatory.
2. **What must happen when the microcontroller does not drive the pin?** During a reset, while the firmware starts, or in deep sleep, the ESP32 pins are not driven. The resistor then sets the state of the line, and this state must be the safe one. For an enable pin that switches something on (like the SD card `OFF` pin, or the gate of a transistor that powers a module), the safe state is "off": a **pull-down** keeps the module off until the firmware decides otherwise.
3. **What does the input require?** Some inputs only react to one level. On the ESP32, `EXT1` can wake the chip when *any* pin goes HIGH, but not when *any* pin goes LOW. Internal resistors also matter: most microcontrollers have internal pull-ups, but not all have internal pull-downs, and the ESP32 GPIOs 34 to 39 have neither.

When none of these constraints applies, **pull-up with active-low** is the most common convention for buttons. One reason is safety with long wires: with a pull-up, the wire going to the button carries GND, and touching a grounded metal part is harmless. With a pull-down, that wire carries 3.3V, and touching a grounded part short-circuits the supply.

Here is how these rules apply to the station of the proof of concept, in the [Fallback AP](../PoC/Phase-03/03-fallback-ap.qmd) chapter:

| Signal | Resistor | Deciding rule |
|---|---|---|
| DS3231 `SQW` (GPIO 36) | Pull-up | Open-drain output (rule 1) |
| SD card `OFF` (GPIO 13) | Pull-down | Module off by default (rule 2) |
| Fallback button (GPIO 39) | Pull-down | Wake-up with `EXT1` on HIGH (rule 3) |

For the button, the drawback of a 3.3V wire is accepted, because the button sits a few centimeters from the board.
