wg1d/personal-autonomous-weather-station/docs/assets/diagrams-src/common.tex

\documentclass[border = 1mm]{standalone}
\usepackage[utf8]{inputenc}
\usepackage{siunitx}
\usepackage[european, straightvoltages, RPvoltages]{circuitikz}
\usetikzlibrary{babel}
\input{DS3231.tex}
\input{BME280.tex}
\input{uPesy_SDCard.tex}
\input{uPesy_ESP32.tex}
