wg1d/personal-autonomous-weather-station/docs/chapters/PoC/Phase-03/02-dummy-backend.qmd

# Dummy Backend Server {.unnumbered}

To verify that the ESP32 transmits its data over Wi-Fi, we need something on the other end to receive it.

Eventually, we will build a real backend on a Single-Board Computer (SBC) such as a Raspberry Pi, with a time-series database. For now, that would distract us from validating the firmware.

Instead, we build a minimal "dummy" backend in Python using **FastAPI**. It takes about 25 lines of code and runs on your computer to prove that the connection works.

## The Code

> **Ready-to-use project:** The complete code for this dummy server is available in the repository here: [`dummy_server`](https://github.com/wg1d/personal-autonomous-weather-station/tree/main/backend/Phase-03/dummy_server)

The project's [pixi](https://pixi.sh) environment already includes Python, FastAPI and uvicorn, with the versions frozen in `pixi.lock` (see the repository README). To start the server, open a terminal at the root of the repository and run:

```bash
pixi run dummy-server
```

Without pixi, any Python 3.12 environment works: install the two dependencies with `pip install fastapi "uvicorn[standard]"`, then run `python main.py` from the `backend/Phase-03/dummy_server` folder.

## The Server Code

For reference, the entire server is about 25 lines of code:

```{.python include="../../../../backend/Phase-03/dummy_server/main.py"}
```

## Running the Test

1. Ensure your server is running (`pixi run dummy-server`).
2. You will see a message indicating the server is running on `http://0.0.0.0:5000`.
3. Power on your ESP32.
4. Watch the Python terminal: at the next wake-up, the server logs the size of the received data, and a `received_data.csv` file appears in the folder. Each upload overwrites this file, which is fine since the ESP32 always sends the whole CSV.

### Expected Output

If everything works, you should see the following logs on both devices.

**ESP32 Serial Monitor:**
```text
--- Waking up from Deep Sleep ---
Wakeup by external signal using RTC_IO (RTC Alarm)
Data: 2026-07-23T17:21:00,29.72,29.94,992.06
Data saved to SD card.
Connecting to WiFi....
Connected to WiFi network
Uploading CSV file to server: http://192.168.1.15:5000/upload
HTTP Response code: 200
Next reading scheduled for: 17:21:30
Entering Deep Sleep...
```

**Python Dummy Server Terminal:**
```text
--- Received 1250 bytes of CSV data! ---
Successfully saved to received_data.csv
---------------------------------------------
INFO:     192.168.1.35:60951 - "POST /upload HTTP/1.1" 200 OK
```

## Next Steps

The ESP32 now transmits its readings over the local Wi-Fi: the end-to-end data path works. But what if the station is out of Wi-Fi range? How do you get the data?

In the next chapter, we build a fallback mechanism: a push-button that makes the ESP32 broadcast its *own* Wi-Fi network, so you can download the data with your phone.
