wg1d/personal-autonomous-weather-station/docs/chapters/PoC/Phase-03/04-ntp-sync.qmd

# Bonus: NTP Time Synchronization {.unnumbered}

Even the DS3231 drifts: at ±2 ppm, up to about one minute per year, more at extreme temperatures. Its initial setting (the compile time) is also only accurate to a few seconds. Since the station already connects to Wi-Fi to upload its data, it can correct its clock at the same time.

In this bonus chapter, we implement **Network Time Protocol (NTP)** synchronization. Whenever the station connects to Wi-Fi and uploads its data, it queries an NTP server and corrects the DS3231 if needed.

## How NTP Works

NTP is the standard protocol that computers use to synchronize their clocks over the internet. NTP servers are themselves synchronized, directly or through other servers, with reference clocks such as atomic clocks or GPS receivers. The ESP32 Arduino core includes an NTP client, configured with the `configTime()` function.

1. The ESP32 connects to an NTP server pool (e.g., `pool.ntp.org`).
2. The server responds with the current time; the ESP32 compensates for the network delay and sets its internal system clock.
3. We read this system clock as a Unix timestamp (`time()`), compare it with the DS3231, and write it to the DS3231 if the difference is too large.

> **Timezone Considerations:** As decided in Phase 01, the station stores and transmits timestamps in **UTC (Coordinated Universal Time)**, which has no daylight saving time. NTP works in UTC, so we set both offsets to `0`. Conversion to local time is done by the dashboard, not by the station.

## The Code

> **Ready-to-use project:** The complete code for this time synchronization firmware is available in the repository here: [`08_ntp_sync`](https://github.com/wg1d/personal-autonomous-weather-station/tree/main/firmware/PoC/Phase-03/08_ntp_sync)

To use the time functions, we include `<time.h>` at the top of the file:

```cpp
#include <time.h>
```

In **Path B** (Standard Wakeup), right after we successfully upload the CSV to our dummy backend server and before we disconnect from Wi-Fi, we run our self-healing logic:

```cpp
// Bonus: NTP Time Synchronization
Serial.println("Synchronizing DS3231 RTC with NTP...");
configTime(0, 0, "pool.ntp.org"); // Offsets 0: we want UTC

struct tm timeinfo;
if (getLocalTime(&timeinfo, 5000)) { // 5-second timeout
  Serial.println("NTP Time acquired!");

  // Both values are Unix timestamps (seconds since 1970, UTC)
  uint32_t ntpUnix = (uint32_t)time(nullptr);
  uint32_t rtcUnix = rtc.now().unixtime();

  // Only update if the drift is greater than 2 seconds: both clocks
  // are only read to the second, so smaller gaps are just noise.
  if (abs((long)(ntpUnix - rtcUnix)) > 2) {
    Serial.println("Drift detected! Updating RTC...");
    rtc.adjust(DateTime(ntpUnix));
  } else {
    Serial.println("RTC time is accurate. No update needed.");
  }
} else {
  Serial.println("Failed to obtain time from NTP server.");
}
```

### Understanding the Code
- `configTime(gmtOffset, daylightOffset, server)`: configures the ESP32's SNTP client. We pass `0` for both offsets to stay in UTC, and use `pool.ntp.org`, a public pool of NTP servers.
- `getLocalTime(&timeinfo, 5000)`: waits until the system clock has been set by NTP. If no answer arrives within 5 seconds, it gives up, to avoid keeping the Wi-Fi on for nothing.
- `time(nullptr)`: returns the system clock as a Unix timestamp (seconds since 1970-01-01 UTC), the same unit as `rtc.now().unixtime()`, so both clocks can be compared directly.
- **The Drift Check:** We only update the RTC when the difference exceeds 2 seconds. Both clocks are read with a one-second resolution, and writing the time to the DS3231 resets its internal sub-second counter: a difference of one second is often just rounding, and correcting it at every wake-up would add as much error as it removes. The 2-second threshold means we only intervene when there is a real drift.
- **Scheduling after a correction:** the next alarm is computed from `rtc.now()` read *after* the synchronization, so a large correction (like the test below) immediately moves the schedule to the correct time.

## Running the Test

To prove that our self-healing logic actually works, we need to intentionally break the clock!

1. In the `setup()` function of `08_ntp_sync.ino`, temporarily add `rtc.adjust(DateTime(2000, 1, 1, 0, 0, 0));` right after `rtc.begin()`.
2. Compile and upload the code.
3. Remove the line you just added, and upload it again. The RTC now believes it is the year 2000.
4. Watch the Serial Monitor as it wakes up, reads the sensors, connects to Wi-Fi, uploads the data, and triggers the NTP sync.

### Expected Output

```text
--- Waking up from Deep Sleep ---
Standard Wakeup (RTC Alarm). Taking reading...
Data: 2000-01-01T00:00:30,29.41,32.10,990.87
Data saved to SD card.
Connecting to WiFi...
Connected to WiFi network
Uploading CSV file to server: http://192.168.1.15:5000/upload
HTTP Response code: 200
Synchronizing DS3231 RTC with NTP...
NTP Time acquired!
Drift detected! Updating RTC...
Next reading scheduled for: 17:15:00
Entering Deep Sleep...
```

The first timestamp is `2000-01-01`, but after the NTP synchronization, the next alarm is scheduled at the real time (`17:15:00`).

The station now corrects its clock automatically whenever it has Wi-Fi access. Note that the reading taken during this wake-up keeps its wrong timestamp: the production architecture will need a policy for data recorded before the clock was known to be valid.

## Next Steps

With NTP synchronization, the PoC feature set is complete. The last PoC chapter, the [Power Budget](05-power-budget.qmd), takes stock of its energy consumption: which components and which choices drain the battery.
