wg1d/personal-autonomous-weather-station/docs/chapters/PoC/Phase-01/02-data-acquisition.qmd

# Data Acquisition {.unnumbered}
Let's start working on how to collect data from our environment. In this chapter, we will focus on the sensors, which involves two steps:

1. Connect the sensor (BME280) to the ESP32 on a breadboard.
2. Program the ESP32 to collect data from the sensor.

## Connect the BME280 to the ESP32

The BME280 sensor measures temperature, humidity, and atmospheric pressure, which makes it a good first sensor for our weather station.

### The I2C Interface
To communicate with the ESP32, the BME280 uses a digital communication protocol called **I2C** (Inter-Integrated Circuit).

I2C is a very popular communication protocol for microcontrollers because it allows you to connect multiple sensors to the same two pins. It uses two lines:
*   **SCL (Serial Clock):** Synchronizes the data transfer.
*   **SDA (Serial Data):** Carries the actual data.

Each sensor on the I2C "bus" has a unique address (like a house number) so the ESP32 knows exactly which sensor it's talking to.

### Pinout

The BME280 module typically has 4 pins (we will focus on the I2C version):

*   **VIN:** Power supply input (3.3V).
*   **GND:** Ground connection.
*   **SCL:** Serial Clock for I2C communication.
*   **SDA:** Serial Data for I2C communication.

BME280 Standalone Circuit

### Wiring the Components
The ESP32 has default pins for I2C communication. We will connect the BME280 as follows:

*   **VIN:** Connect to the ESP32 **3.3V** pin.
*   **GND:** Connect to an ESP32 **GND** pin.
*   **SCL:** Connect to ESP32 Pin **22**.
*   **SDA:** Connect to ESP32 Pin **21**.

Connection between ESP32 and BME280

## Program the ESP32 to Read the BME280

### Setup
Now that the sensor is wired, let's write a simple program to read the data and print it to the Serial Monitor. We'll put this in a loop with a small delay so it continuously outputs the readings.

If you are using the standard Arduino IDE, you need to manually install the **Adafruit BME280 Library** and the **Adafruit Unified Sensor** library using the Library Manager.

With **PlatformIO** (which we recommend), dependency management is automated: you declare the libraries in your `platformio.ini` file, and PlatformIO downloads them the first time you compile. We pin exact versions so that the project still builds the same way in a few years.

Here is the `platformio.ini` configuration for this project:

```{.ini include="../../../../firmware/PoC/Phase-01/01_data_acquisition/platformio.ini"}
```

> **Ready-to-use project:** The complete code for this data acquisition phase is available in the repository here: [`01_data_acquisition`](https://github.com/wg1d/personal-autonomous-weather-station/tree/main/firmware/PoC/Phase-01/01_data_acquisition)

> **Library Reference:** We use the official Adafruit library and follow their BME 280 example [Adafruit BME280 Library](https://github.com/adafruit/Adafruit_BME280_Library/blob/master/examples/bme280test/bme280test.ino).

### The Code

Here is the code to read the sensor:

```{.cpp include="../../../../firmware/PoC/Phase-01/01_data_acquisition/01_data_acquisition.ino"}
```

### Code Explanation

Here is a quick breakdown of what the code is doing:

1. **`Adafruit_BME280 bme;`**: This creates an object named `bme` that we use to interact with the sensor via the Adafruit library.
2. **`bme.begin(0x76)`**: This initializes the sensor on the I2C bus using the specific address `0x76` (common for BME280 modules). If it returns false, it means the ESP32 cannot communicate with the sensor (likely a wiring issue).
3. **`bme.readTemperature()`, `bme.readHumidity()`, `bme.readPressure()`**: These functions retrieve the latest measurements from the sensor. Note that `readPressure()` returns the value in Pascals, so we divide it by `100.0F` to convert it to hectoPascals (hPa), which is the standard unit for weather forecasting.

Before running this code, make sure your ESP32 is connected to your computer via a **USB-C cable**. This connection is necessary to power the board, upload the program, and view the data coming back over the Serial connection.

### Expected Output
After building and uploading the code, you should see something like this in the Serial Monitor (if it's not the case, restart the esp by pressing the EN button):

```text
BME280 Initialization Test
Temperature: 29.31 *C
Humidity: 35.68 %
Pressure: 1000.12 hPa
-------------------------
Temperature: 29.36 *C
Humidity: 35.34 %
Pressure: 1000.10 hPa
-------------------------
Temperature: 29.41 *C
Humidity: 35.25 %
Pressure: 1000.14 hPa
-------------------------
```

### Troubleshooting

- **`Could not find a valid BME280 sensor`**: check the wiring first (SDA and SCL are easy to swap). If the wiring is correct, your module probably uses the other I2C address: replace `0x76` with `0x77`.
- **Garbage characters in the Serial Monitor**: the monitor speed must match `Serial.begin()`, i.e. `monitor_speed = 115200` in `platformio.ini`.
- **Upload fails with a permission error on Linux**: add your user to the `dialout` group (`sudo usermod -aG dialout $USER`), then log out and back in.
- **A BMP280 instead of a BME280**: some cheap modules sold as BME280 are BMP280s, which have no humidity sensor. The library then fails to initialize or humidity stays at 0 %.

## Next Steps

Now that we can read the environment, we need a place to store the measurements. In the next chapter, we connect an SD card module so the station can keep its data offline.
