wg1d/personal-autonomous-weather-station/docs/assets/images/outdoor-station.jpeg

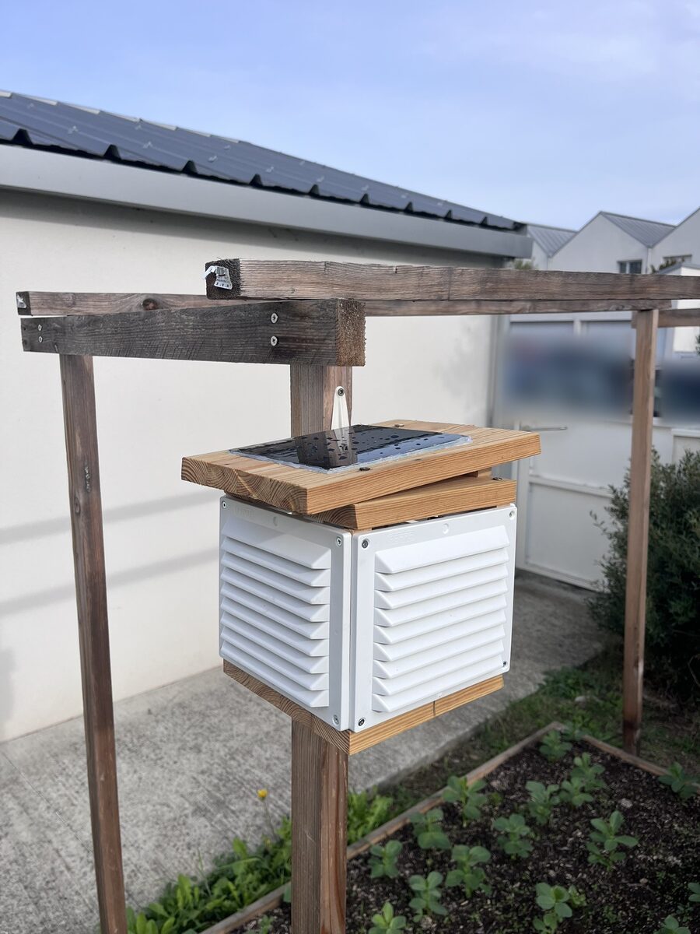
docs/assets/images/outdoor-station.jpeg
