wg1d/personal-autonomous-weather-station/docs/chapters/Outdoor/02-parts-list.qmd

# Outdoor Station Parts List {.unnumbered}

Everything to buy for the outdoor station, shop by shop, as a shopping list. The [design chapter](00-design.qmd) explains the choice of each part, and the [power chapter](01-power.qmd) how the power parts connect.

::: {.callout-note}
The prices are those of the shops linked, in euros, at the time of writing, without the shipping costs.
:::

## Gotronic: electronics and cables, about 65 €

[Gotronic](https://www.gotronic.fr) is a French shop that sells the Seeed Studio, Adafruit and DFRobot boards.

| Qty | Part | Price |
|-----|---|---|
| 1 | [XIAO ESP32-S3, pins soldered](https://www.gotronic.fr/art-carte-xiao-esp32s3-soude-47619.htm) | 10.50 € |
| 1 | [Grove Shield for XIAO](https://www.gotronic.fr/art-shield-grove-xiao-103020312-32393.htm) | 4.90 € |
| 1 | [Charger bq24074 (Adafruit 4755)](https://www.gotronic.fr/art-chargeur-d-accu-lipo-3-7-vcc-ada4755-33478.htm) | 17.90 € |
| 1 | [LiPo battery, 1000 mAh, JST-PH](https://www.gotronic.fr/art-accu-lipo-3-7-vcc-1000-mah-pr523450-5813.htm) | 9.90 € |
| 1 | [Thermistor NTC 10 kΩ](https://www.gotronic.fr/art-thermistance-ctn-10k-8486-3739.htm) | 0.80 € |
| 1 | [Waterproof push button, IP67, 16 mm](https://www.gotronic.fr/art-bouton-poussoir-bp16039-29350.htm) | 4.60 € |
| 2 | [Grove I2C hub, 6 ports](https://www.gotronic.fr/art-hub-6-ports-i2c-grove-103020272-31348.htm) | 3.80 € |
| 1 | [Grove cables, 30 cm, set of 5](https://www.gotronic.fr/art-lot-de-5-cables-grove-30-cm-22557.htm) | 3.30 € |
| 1 | [Grove to female connectors cables, 30 cm, set of 5](https://www.gotronic.fr/art-5-cables-30-cm-grove-4-contacts-femelles-19069.htm) | 4.20 € |
| 2 | [JST-PH 2-pin cable, with its plug](https://www.gotronic.fr/art-cordon-jst-ph-femelle-2-cts-jst2-21318.htm) | 4.40 € |

What each cable connects:

- **Grove I2C hubs**: one in the sealed box, for the clock and the INA219, and one in the shelter, for the BME280 and the later sensors. A single cable goes from the box to the shelter.
- **Grove cables**: the Grove Shield to the hub of the box, and this hub to the hub of the shelter; the others are spares for the later sensors.
- **Grove to female connectors cables**: the clock, the INA219, the air sensors (see [Sensors and clock](#sensors-and-clock-two-options)), and one cable shared by the alarm of the clock and the maintenance button.
- **JST-PH cables**: the charger to the Grove Shield, and the charger to the INA219 and the battery.

## Amazon: panel, battery monitor and coin cells, about 26 €

| Qty | Part | Price |
|-----|---|---|
| 1 | [Solar panel, 6 V, 3 W, with a 5.5 × 2.1 mm plug](https://www.amazon.fr/Monocristallin-Ext%C3%A9rieur-Stratifi%C3%A9e-T%C3%A9l%C3%A9phone-14-5Cmx14-5Cm/dp/B08G8TT5Q7) | 16.99 € |
| 1 | [INA219 module](https://www.amazon.fr/DollaTek-capteur-Courant-Alternatif-bidirectionnel/dp/B07DK7Y35Q) | 5.99 € |
| 1 | [CR2032 coin cells, Varta, 5](https://www.amazon.fr/Varta-2032-Pile-Lithium-Pi%C3%A8ces/dp/B00TYEL11K), for the clock | about 3.40 € |

The generic INA219 module copies the design of Adafruit: the same chip and the same 0.1 Ω shunt resistor, marked R100.

## DIY store: the shelter and small parts

| Qty | Part | Price |
|-----|---|---|
| 4 | Louvered vent grilles in ABS, 23 × 23 cm | 4 × 10.90 € |
| 1 | [Planed pine batten 21 × 21 mm, 2.4 m](https://www.castorama.fr/tasseau-rabote-pin-21-x-21-mm-l-2-4-m/3663602858096_CAFR.prd) | 5.65 € |
| 1 | Pine shelf board 200 × 30 cm, 18 mm | about 11.50 € |
| 1 | Junction box 115 × 115 × 60 mm, IP55, with rubber membranes | about 3 € |
| 1 | White paint for wood, 0.5 L, and a primer for plastics | 17 to 30 € |
| 4 | Reinforced stainless angle brackets, about 60 mm, to hold the shelter on the trellis | to price |
| 1 | Stainless wood screws, 4 × 30 mm, a small pack | to price |
| 1 | M3 screw of 30 mm with three nuts, for the BME280 (one for each module with a SHT31 and a BMP280) | a few cents |
| 1 | Roll of double-sided tape, for the modules and the battery | a few euros |
| 1 | Pack of lever connectors, Wago 221, for the two black wires of the battery: the 221 series takes wires from 0.14 mm², the S221 series only from 0.5 mm², too thick for the thin wires of the JST-PH cables | about 4 to 8 € |
| 1 | Assortment of heat-shrink tubing, for the solder joints of the thermistor and of the battery socket | a few euros |
| 1 | Digital multimeter, with a continuity tester and DC voltage, to check the polarity before each connection | about 10 € |

Nothing else is needed: a bag of silica gel kept from a shoe box absorbs the condensation of the sealed box, and any adhesive tape holds the thermistor against the battery. The tools are a soldering iron with its solder, a cutter, a saw, and a drill with a hole saw of 20 mm and a spade bit of 16 mm.

## Sensors and clock: two options

The air sensors and the clock depend on where you start from.

### Starting from scratch (recommended)

A SHT31 for the temperature and the humidity, the sensor of 3D-PAWS, about three times more accurate than a BME280, and a BMP280 for the pressure. Both plug into the hub of the shelter.

| Qty | Part | Price |
|-----|---|---|
| 1 | [SHT31 module](https://www.amazon.fr/-/en/DAOKAI-Temperature-Humidity-SHT31-D-Interface/dp/B0CZHTWLJZ), Amazon: ±0.3 °C, ±2 % RH | 8.99 € |
| 1 | [BMP280 modules, 3.3 V, set of 2](https://www.amazon.fr/TECNOIOT-Barometric-Pressure-dimpression-d%C3%A9rivation/dp/B07HM8WRV3), Amazon: the pressure, ±1 hPa | 7.76 € |
| 1 | [DS3231 clock module](https://www.gotronic.fr/art-module-rtc-i2c-ds3231-gt584-36063.htm), Gotronic: the common ZS-042 module, with its CR2032 cell; its LED is removed (see [The DS3231 Module](../Appendix/04-ds3231-module.qmd)) | 7.90 € |
| 1 | USB-C data cable, to program the XIAO | a few euros |
| 2 | Male-to-male jumper wires, for the maintenance button | a few cents |

With the two sensors, the station uses five Grove to female connectors cables: the set of the Gotronic list is enough.

### With the bench station

The station of the [Phase 4](../Architecture/Phase-04/00-1-requirements.qmd), on its breadboard, already has a BME280 (temperature, humidity and pressure, ±1 °C, ±3 % RH), a DS3231 module, a USB-C cable and jumper wires: they move to the outdoor station, and nothing more is bought. With the BME280, the station uses four Grove to female connectors cables, and one stays spare. A SHT31 can replace the BME280 later, for a more accurate temperature.

## Later sensors

The parts of the sensors that come later, such as a more accurate SHT31, the light and the UV, the rain gauge, the wind speed and direction, or the soil moisture, are chosen in their own steps. Each step adds its parts to this list. The [design chapter](00-design.qmd#later-sensors) already reserves their place.
