wg1d/personal-autonomous-weather-station/docs/assets/diagrams-src/component_bme280.tex

\input{common.tex}

\begin{document}
\begin{circuitikz}
\pic (bme) at (0,0) {bme280};
\end{circuitikz}
\end{document}
