wg1d/personal-autonomous-weather-station/docs/assets/diagrams-src/component_ds3231.tex

\input{common.tex}

\begin{document}
\begin{circuitikz}
\pic (rtc) at (0,0) {ds3231};
\end{circuitikz}
\end{document}
