wg1d/personal-autonomous-weather-station/docs/assets/diagrams-src/component_sdcard.tex

\input{common.tex}

\begin{document}
\begin{circuitikz}
\pic (sd) at (0,0) {sdcard};
\end{circuitikz}
\end{document}
