wg1d/personal-autonomous-weather-station/docs/assets/images/ds3231-module-parts.jpeg

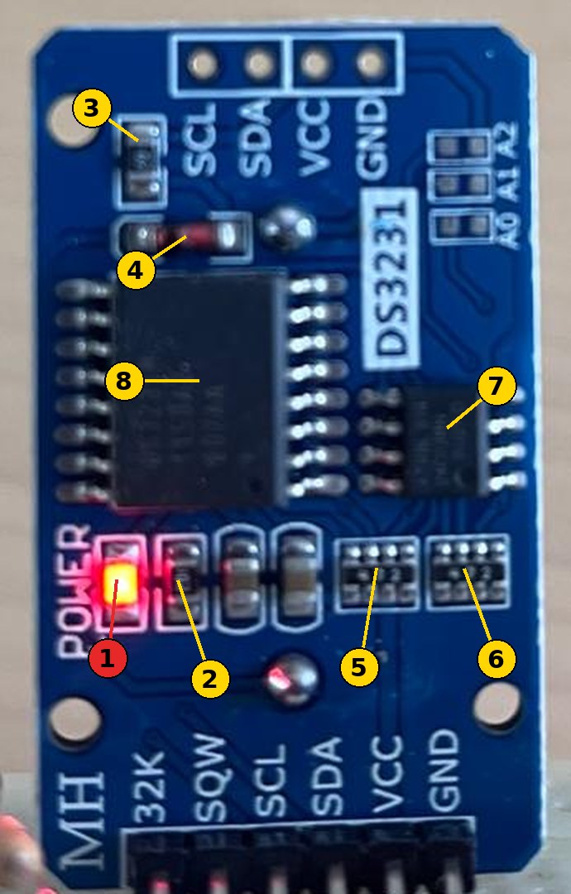
docs/assets/images/ds3231-module-parts.jpeg
