wg1d/personal-autonomous-weather-station/(list of files, drawings)

Other design files:
docs/assets/circuits/pawsfzz.fzz
