wg1d/personal-autonomous-weather-station/firmware/PoC/Phase-03/07_wifi_fallback_ap/07_wifi_fallback_ap.ino

/*
 * Project: Personal Autonomous Weather Station
 * Phase 03: Wi-Fi & Data Transmission
 * File: 07_wifi_fallback_ap.ino
 *
 * Description:
 * Implements a dual-boot logic. If woken by the RTC alarm (EXT0), it logs
 * data, connects to Wi-Fi, uploads the CSV, and goes to sleep.
 * If woken by the Fallback Button on Pin 39 (EXT1), it starts a local
 * Access Point and hosts a web server to download or delete the CSV.
 *
 * Wiring:
 * - BME280:  3.3V -> VIN, GND -> GND, Pin 21 -> SDA, Pin 22 -> SCL
 * - DS3231:  3.3V -> VCC, GND -> GND, Pin 21 -> SDA, Pin 22 -> SCL,
 *            Pin 36 -> SQW (Requires a 10k pull-up resistor to 3.3V)
 * - SD Card: 5V   -> VCC, GND -> GND, Pin 19 -> MISO, Pin 23 -> MOSI,
 *            Pin 18 -> SCLK, Pin 5 -> CS,
 *            Pin 13 -> OFF (Requires a 10k pull-down resistor to GND)
 * - Button:  3.3V -> Button -> Pin 39 (Requires a 10k pull-down to GND)
 */

#include <Arduino.h>
#include <Adafruit_Sensor.h>
#include <Adafruit_BME280.h>
#include <SPI.h>
#include <SD.h>
#include <FS.h>
#include <RTClib.h>
#include <WiFi.h>
#include <HTTPClient.h>
#include <ESPAsyncWebServer.h>
#include "secrets.h"

#define SD_CS_PIN 5
#define SD_OFF_PIN 13
#define RTC_WAKEUP_PIN 36
#define FALLBACK_BUTTON_PIN 39

// Offset between your computer's local time and UTC, in seconds.
// Used only to convert the compile time to UTC when setting the RTC.
// Example: Paris is UTC+1 in winter (3600) and UTC+2 in summer (7200).
#define COMPILE_TIME_UTC_OFFSET 7200

Adafruit_BME280 bme;
RTC_DS3231 rtc;
AsyncWebServer server(80);

const int WAKEUP_INTERVAL_SECONDS = 30;
const unsigned long AP_TIMEOUT_MS = 180000; // 3 minutes
const char* serverName = "http://192.168.1.15:5000/upload";

// Access Point credentials. Change the password before deploying the
// station: WPA2 requires at least 8 characters.
const char* AP_SSID = "WeatherStation_AP";
const char* AP_PASSWORD = "12345678";

const char* INDEX_HTML =
  "<html><head>"
  "<meta name='viewport' content='width=device-width, initial-scale=1'>"
  "<style>"
  "body{font-family:Arial,sans-serif;text-align:center;padding:50px;}"
  "button{padding:15px 30px;font-size:18px;margin:10px;cursor:pointer;"
  "border:none;border-radius:8px;}"
  ".btn-down{background:#4CAF50;color:white;}"
  ".btn-del{background:#f44336;color:white;}"
  "</style></head>"
  "<body><h1>Weather Station</h1>"
  "<a href='/download'>"
  "<button class='btn-down'>Download CSV</button></a><br><br>"
  "<form action='/delete' method='POST'>"
  "<button type='submit' class='btn-del'>Delete Old Data</button></form>"
  "</body></html>";

const char* DELETED_HTML =
  "<html><head>"
  "<meta name='viewport' content='width=device-width, initial-scale=1'>"
  "<style>body{font-family:Arial,sans-serif;text-align:center;"
  "padding:50px;}</style></head>"
  "<body><h2>Data Deleted!</h2><a href='/'>Back</a></body></html>";

void appendFile(fs::FS &fs, const char * path, const char * message) {
  File file = fs.open(path, FILE_APPEND);
  if (file) {
    file.print(message);
    file.close();
  }
}

void armWakeupSources() {
  esp_sleep_enable_ext0_wakeup((gpio_num_t)RTC_WAKEUP_PIN, 0);
  esp_sleep_enable_ext1_wakeup(1ULL << FALLBACK_BUTTON_PIN,
                               ESP_EXT1_WAKEUP_ANY_HIGH);
}

void setup() {
  Serial.begin(115200);
  Serial.println("\n--- Waking up from Deep Sleep ---");

  esp_sleep_wakeup_cause_t wakeup_reason = esp_sleep_get_wakeup_cause();

  if (wakeup_reason == ESP_SLEEP_WAKEUP_EXT1) {
    // ==========================================
    // PATH A: FALLBACK ACCESS POINT MODE
    // ==========================================
    Serial.println("Wakeup by Fallback Button! Starting AP Mode...");

    // 1. Power on SD Card to serve the file
    pinMode(SD_OFF_PIN, OUTPUT);
    digitalWrite(SD_OFF_PIN, HIGH); // Power on the SD card
    delay(500); // Wait for power to stabilize
    if (!SD.begin(SD_CS_PIN)) {
      Serial.println("Card Mount Failed in AP mode");
    }

    // 2. Start Wi-Fi Access Point
    WiFi.softAP(AP_SSID, AP_PASSWORD);
    Serial.print("AP IP address: ");
    Serial.println(WiFi.softAPIP());

    // 3. Setup Web Server Routes
    server.on("/", HTTP_GET, [](AsyncWebServerRequest *request){
      request->send(200, "text/html", INDEX_HTML);
    });

    server.on("/download", HTTP_GET, [](AsyncWebServerRequest *request){
      if (!SD.exists("/weather_data.csv")) {
        request->send(404, "text/plain", "File not found.");
        return;
      }
      Serial.println("User is downloading weather_data.csv...");
      request->send(SD, "/weather_data.csv", "text/csv", true);
    });

    server.on("/delete", HTTP_POST, [](AsyncWebServerRequest *request){
      if (SD.exists("/weather_data.csv")) {
        SD.remove("/weather_data.csv");
        Serial.println("User deleted weather_data.csv!");
      }
      request->send(200, "text/html", DELETED_HTML);
    });

    server.begin();
    Serial.println("Web server started.");

    // Return from setup() to allow loop() to handle the 3-minute timeout
    return;
  }

  // ==========================================
  // PATH B: STANDARD SENSOR & UPLOAD MODE
  // ==========================================
  Serial.println("Standard Wakeup (RTC Alarm). Taking reading...");

  if (!rtc.begin()) {
    // Without the RTC we can neither timestamp nor schedule: only the
    // button can wake the station up again.
    Serial.println("Couldn't find RTC");
    armWakeupSources();
    Serial.flush();
    esp_deep_sleep_start();
  }
  if (rtc.lostPower()) {
    // __DATE__ and __TIME__ are in local time: convert them to UTC.
    DateTime compileTime(F(__DATE__), F(__TIME__));
    rtc.adjust(compileTime - TimeSpan(COMPILE_TIME_UTC_OFFSET));
  }

  // Capture timestamp immediately before any delays!
  DateTime bootTime = rtc.now();

  rtc.disable32K();
  rtc.writeSqwPinMode(DS3231_OFF);
  rtc.disableAlarm(2);
  rtc.clearAlarm(1);
  rtc.clearAlarm(2);

  // A missing sensor must not stop the station: we log NaN values and
  // keep the schedule running.
  if (bme.begin(0x76)) {
    bme.setSampling(Adafruit_BME280::MODE_FORCED,
                    Adafruit_BME280::SAMPLING_X1,  // temperature
                    Adafruit_BME280::SAMPLING_X1,  // pressure
                    Adafruit_BME280::SAMPLING_X1,  // humidity
                    Adafruit_BME280::FILTER_OFF);
    bme.takeForcedMeasurement();
  } else {
    Serial.println("Could not find a valid BME280 sensor, check wiring!");
  }

  pinMode(SD_OFF_PIN, OUTPUT);
  digitalWrite(SD_OFF_PIN, HIGH);
  delay(500);
  if (!SD.begin(SD_CS_PIN)) {
    Serial.println("Card Mount Failed");
  } else {
    char timestamp[] = "YYYY-MM-DDThh:mm:ss";
    bootTime.toString(timestamp);

    char dataString[100];
    snprintf(dataString, sizeof(dataString), "%s,%.2f,%.2f,%.2f\n",
             timestamp, bme.readTemperature(), bme.readHumidity(),
             bme.readPressure() / 100.0F);

    Serial.print("Data: ");
    Serial.print(dataString);

    if (!SD.exists("/weather_data.csv")) {
      appendFile(SD, "/weather_data.csv",
                 "timestamp,temperature,humidity,pressure\n");
    }
    appendFile(SD, "/weather_data.csv", dataString);
    Serial.println("Data saved to SD card.");

    // Connect to Wi-Fi and Upload
    WiFi.begin(WIFI_SSID, WIFI_PASSWORD);
    Serial.print("Connecting to WiFi...");

    int wifi_timeout = 0;
    while (WiFi.status() != WL_CONNECTED && wifi_timeout < 20) {
      delay(500);
      Serial.print(".");
      wifi_timeout++;
    }

    if (WiFi.status() == WL_CONNECTED) {
      Serial.println("\nConnected to WiFi network");
      HTTPClient http;
      http.begin(serverName);
      http.addHeader("Content-Type", "text/csv");

      File file = SD.open("/weather_data.csv");
      if (file) {
        Serial.print("Uploading CSV file to server: ");
        Serial.println(serverName);
        int httpResponseCode = http.sendRequest("POST", &file, file.size());
        Serial.print("HTTP Response code: ");
        Serial.println(httpResponseCode);
        file.close();
      } else {
        Serial.println("Failed to open file for uploading");
      }
      http.end();
    } else {
      Serial.println("\nWiFi connection failed, aborting upload.");
    }

    WiFi.disconnect(true);
    WiFi.mode(WIFI_OFF);
  }

  SD.end();
  digitalWrite(SD_OFF_PIN, LOW); // Power OFF SD card

  // 5. Set the next wake-up alarm exactly on the grid.
  // We read the time again: the work above took some time, and an alarm
  // set in the past would only fire the next day (it matches H:M:S).
  uint32_t currentUnix = rtc.now().unixtime();
  uint32_t remainder = currentUnix % WAKEUP_INTERVAL_SECONDS;
  uint32_t nextAlarmUnix = currentUnix - remainder + WAKEUP_INTERVAL_SECONDS;
  DateTime future(nextAlarmUnix);

  if (!rtc.setAlarm1(future, DS3231_A1_Hour)) {
    Serial.println("Error setting alarm!");
  } else {
    Serial.printf("Next reading scheduled for: %02d:%02d:%02d\n",
                  future.hour(), future.minute(), future.second());
  }

  // Go to Deep Sleep
  armWakeupSources();

  Serial.println("Entering Deep Sleep...");
  Serial.flush();
  esp_deep_sleep_start();
}

void loop() {
  esp_sleep_wakeup_cause_t wakeup_reason = esp_sleep_get_wakeup_cause();
  if (wakeup_reason == ESP_SLEEP_WAKEUP_EXT1) {
    // AP Mode Timeout Logic (3 Minutes)
    static unsigned long apStartTime = millis();
    static unsigned long lastPrintTime = millis();
    unsigned long elapsed = millis() - apStartTime;

    // Print remaining time every 10 seconds
    if (millis() - lastPrintTime >= 10000) {
      lastPrintTime = millis();
      int remainingSeconds = (AP_TIMEOUT_MS - elapsed) / 1000;
      Serial.printf("AP Mode shutting down in %d seconds...\n",
                    remainingSeconds);
    }

    if (elapsed > AP_TIMEOUT_MS) {
      Serial.println("\nAP Timeout reached. Shutting down...");

      // Cleanup
      WiFi.softAPdisconnect(true);
      WiFi.mode(WIFI_OFF);
      SD.end();
      digitalWrite(SD_OFF_PIN, LOW); // Power off SD Card

      // Arm wakeups again
      armWakeupSources();

      Serial.println("Entering Deep Sleep...");
      Serial.flush();
      esp_deep_sleep_start();
    }
  }
}
