wg1d/personal-autonomous-weather-station/(commit log)

2026-05-13 ci: add book render check and sun logo
    - Add book-check.yml: renders Quarto book on PRs touching docs/
    - Add custom sun SVG logo (docs/assets/images/logo.svg)
    - Wire logo into Quarto book sidebar (_quarto.yml)
    - Add logo to README header
2026-05-13 fix(docs): disable reader mode toggle button
2026-05-18 docs: restructure book and extract roadmap
    - Remove redundant FSM diagram from firmware chapter; add cross-ref to architecture
    - Remove partial LED table from architecture; point to firmware as authoritative
    - Add Phase 2 bill of materials to hardware chapter
    - Extract roadmap to ROADMAP.md at repo root
    - Add phase overview table and dependency graph to README
    - Add build philosophy to preface; update How to read table
    - Remove 07-roadmap.qmd from book and delete file
2026-06-01 docs: reorder phases — backend MVP before clean board
    Move backend work (Phase 2) earlier so the full data pipeline is
    validated with prototype hardware before committing to clean hardware.
    New phase order:
    1. Prototype (unchanged)
    2. Backend MVP — InfluxDB v1 + FastAPI + Grafana, no forecasting
    3. Clean board (old Phase 2)
    4. Outdoor deployment (old Phase 3)
    5–7. Extended sensors, Forecasting, Solar (unchanged)
    Switch backend storage from TinyDB to InfluxDB v1 directly — native
    Grafana data source, line protocol ingestion, no migration needed later.
2026-06-01 docs: add phases 8a/8b — Wi-Fi and cellular direct push
    Add connectivity upgrade path as optional phases after the backend MVP:
    - Phase 8a: ESP32 connects to home Wi-Fi post-wake and POSTs directly
    to the FastAPI server. SD logging kept as local buffer. AP/gateway
    mode remains a fallback for field deployments.
    - Phase 8b: GSM/LTE module (SIM7600 or SIM800L) for remote sites with
    no Wi-Fi. Reuses the same PUSH FSM state, swaps transport layer.
    Note in Phase 2 that the gateway script is designed to become optional.
2026-06-22 docs(roadmap): renumber phases 8a/8b to 8/9, fix dependency graph
    - Rename Phase 8a → Phase 8 (Wi-Fi push) and Phase 8b → Phase 9 (Cellular)
    - Remove redundant P4→P6 arrow (P4→P5→P6 already covers it)
    - Move connectivity phases to depend on P4 (outdoor) instead of P2 (backend)
    - Update dependency graph prose to match
2026-06-22 docs(roadmap): restructure into 10-phase linear plan
    - Add Phase 3 (Forecasting basic) after Backend MVP
    - Split sensor validation into individual breadboard phases (4-7)
    - Move model retrain + watering to Phase 8, right after all sensors validated
    - Phase 9: solar + battery bench validation
    - Phase 10: Stevenson screen + outdoor deployment (enclosure assembled once, final)
    - Demote Wi-Fi push and Cellular to clearly marked optional branches
    - Enforce breadboard-first principle: no custom PCB, clean assembly is the last step
2026-06-22 docs: align all files with new 10-phase roadmap structure
    - backend/README: fix phase refs (P4→P2 pipeline, P6→P8 ML), drop TinyDB
    - firmware/README: fix phase ref (clean board→Phase 10), status to in progress
    - docs/02-architecture: update stale Phase 8a/8b callout to optional phases
    - docs/03-hardware: fix all section headers and phase refs (P2→P4-5, P3→P6-7,
    solar P4+→P9+, connector strategy and BoM→P10, reed/hall note)
    - docs/04-firmware: fix example row comment (Phase 2→Phase 7+)
    - docs/05-backend: fix CSV schema phase availability column (P3/P5→P4-7)
    - docs/06-forecasting: fix status, data requirements callout, wind feature ref
2026-06-23 docs: add LoRa connectivity option and IoT framing
    - README/ROADMAP: add LoRa as a third optional connectivity phase
    (alongside Wi-Fi push and Cellular)
    - README/ROADMAP: dependency graphs updated — LoRa and Cellular both
    carry a dashed 'if chosen: before P10' arrow into Phase 10 to make
    the ordering constraint explicit
    - ROADMAP: ordering note rewritten to clarify that LoRa and Cellular
    must be bench-validated before the Stevenson screen enclosure is
    designed and assembled (breadboard-first rule applies)
    - README: subtitle updated to 'IoT weather station'; one-line note
    added calling out the small-scale precision agriculture scope
    - docs/02-architecture: callout updated to inc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
2026-07-08 docs: update sync strategy, add RPi alternative, and schematic guidelines
2026-07-08 chore: archive previous ESP32 sandbox and weather dashboard attempts, add analysis
2026-07-10 docs: add callout explaining internal vs external pull-up resistors
    [pawsfzz.fzz]
2026-07-15 docs & firmware: add prototyping sketches and fix button LED inversion
    [pawsfzz.fzz]
2026-07-19 chore: Archive old prototyping chapter and remove unused circuit file
    [pawsfzz.fzz]
2026-07-20 docs: fix typos and add sensor references in roadmap
2026-07-20 docs: add prototype chapter and explain hardware/software choices
2026-07-20 docs: format hardware links as markdown in prototype chapter
2026-07-21 chore: remove old prototype firmware and chapter
2026-07-21 docs(diagrams): add circuitikz schematic for ESP32 and BME280 wiring
2026-07-22 docs: add SD card storage wiring, tutorial, and C++ code implementation
2026-07-23 feat: add Phase 02 deep sleep power management firmware
2026-07-23 docs: complete Phase 02 power management documentation
2026-07-23 feat: add Phase 02 timer deep sleep firmware example
2026-07-23 docs: clarify EOLab resistor difference and move references before firmware code
2026-07-24 feat(backend): Add FastAPI dummy server for connectivity testing
    Adds a lightweight FastAPI python server to receive and save the CSV payloads from the ESP32. Includes documentation and gitignore updates to prevent pushing raw CSV data.
2026-08-26 refactor: replace monolithic Phase 04 with incremental step-by-step structure
    [main.cpp, secrets.example.h]
2026-08-26 docs: refine formatting – unnumbered titles, correct Phase‑4 name, limit justification to main content
2026-09-28 fix(firmware): make PoC sketches robust and reproducible
    - Compute the next RTC alarm from a fresh rtc.now(), so a long wake-up
    can no longer schedule it in the past (next-day wake-up)
    - Never enter deep sleep without a wake-up source when a device fails;
    log NaN when the BME280 is missing
    - Use the BME280 forced mode so it sleeps between measurements
    - Store time in UTC (convert compile time, use time() for NTP)
    - Unify the CSV header, unmount the SD card before cutting its power
    - Pin platform and library versions, respect the 80-column rule
    - Ignore nested .pio build directories
    [01_data_acquisition.ino, 03_real_time_clock.ino, 05_power_management_rtc.ino, 06_wifi_station.ino, 07_wifi_fallback_ap.ino, 08_ntp_sync.ino]
2026-09-28 docs(poc): fix inaccurate claims, sync code and harmonize tone
    - Correct the SD power pin level, stray code fences, typos and links
    - Fix claims on DS3231 accuracy, ESP32 chip vs board consumption, ULP,
    input-only GPIOs, alarm flag latching and EXT1 trigger modes
    - Add a datasheet-based power budget (estimates, not measurements),
    UTC and DS3231 module callouts, and troubleshooting sections
    - Replace promotional wording with a sober, factual tone
2026-09-28 docs(poc): add pull-up and pull-down button diagrams
    Recovered from the backup branch and shown in the fallback AP chapter.
2026-09-28 docs: include code files in the book instead of copying them
    Use the quarto-ext/include-code-files filter so that full sketches,
    platformio.ini files and the dummy server are read from the repository
    at render time. The book can no longer drift from the code.
2026-09-28 ci: check and publish the book when included code changes
    Trigger the book workflows on firmware and backend code changes, and
    fail the check when an include cannot be resolved (the filter only
    warns and would render an empty code block).
2026-09-28 docs(poc): fix label overlap in released-button diagrams
2026-09-28 docs(poc): add equations to support the explanations
    - Pull-up/pull-down: Ohm's law in both button states, and the maximum
    resistance derived from the ESP32 leakage current and logic levels
    - Power budget: average current and battery life formulas
    - Clock drift in ppm, grid scheduling example, cost of a Wi-Fi upload
2026-09-28 fix(poc): use the standard comma separator in CSV files
    Write comma-separated values (RFC 4180) in every PoC sketch and update
    the example outputs in the book, so that the whole project uses the
    same CSV format as the Phase 4 firmware.
    [02_data_storage.ino, 03_real_time_clock.ino, 05_power_management_rtc.ino, 06_wifi_station.ino, 07_wifi_fallback_ap.ino, 08_ntp_sync.ino]
2026-09-28 docs(poc): move the power budget to the end of the PoC
    Give the power budget its own chapter, closing Phase 3: it gathers the
    estimation method, the deep sleep consumption and the cost of Wi-Fi,
    which are then used by the Phase 4 design.
2026-09-28 ci: update actions and pin the runner and Quarto versions
    - Update actions/checkout (v7), upload-pages-artifact (v5) and
    deploy-pages (v5), which no longer run on the deprecated Node.js 20
    - Pin quarto-actions/setup by SHA and Quarto to 1.7.32 (local version)
    - Pin the runner to ubuntu-24.04 before ubuntu-latest moves to 26
    - Run the publish workflow when its own definition changes
2026-09-29 feat(firmware): add the A1 skeleton with the state machine and tests
    Interfaces (lib/ports), core rules and state machine (lib/core), test
    doubles, unit and scenario tests (native env), and skeleton adapters
    running the state machine on the board with timer-only deep sleep.
2026-09-29 docs(arch): align the design chapter with the A1 implementation
    List IMaintenance, base the upload rule on the measurement slot, and
    replace config.h with the Config structure of the core.
2026-09-29 docs(arch): split the design chapter into four chapters
    Requirements, Behavior, Data and Upload, and Structure and
    Verification. Each notion is now introduced before it is used, the
    verification matrix comes after everything it checks, and the project
    layout is only described in the A1 chapter. Links from the A1 and
    Power Budget chapters point to the new pages.
2026-10-02 docs(arch): show the walking skeleton output printed on the board
    The expected output of step A1 is now the real output of two wake-ups,
    with the boot messages of the ESP32 between them.
2026-10-02 refactor(firmware): simplify the state machine
    Replace the state listener, the visited-states array and enter() with
    an ILog interface: SerialLog prints the states on the board, and
    FakeLog keeps them for the tests. Replace RetainedState with
    IClock::lastSetTime(): the clock remembers when it was last set.
    [SerialLog.h, main.cpp]
2026-10-02 feat(firmware): A2, DS3231 clock and RTC alarm wake-up
    Ds3231Clock replaces the skeleton SystemClock: real timestamps,
    validity from the Oscillator Stop Flag, and alarm 1 on the measurement
    grid. Esp32Power arms the EXT0 wake-up on pin 36 when an alarm is set;
    the safety timer stays armed. Demo interval: one minute.
    [Ds3231Clock.h, Esp32Power.h, main.cpp]
2026-10-02 docs(arch): write the A2 chapter, DS3231 clock
    Wiring, clock adapter, alarm wake-up, and the output printed by the
    board with the clock lost and with the clock set.
2026-10-02 feat(firmware): A3, BME280 sensor and SD card storage
    The core formats the rows in the CSV v1 format (formatCsvRow(), tested
    on the computer). Bme280Sensor reads the sensor in forced mode;
    SdStorage powers the card module on, appends the row to
    /measurements_v1.csv (with the header for a new file), and powers it
    off. NullSensor and SerialStorage are removed.
2026-10-02 docs(arch): write the A3 chapter, sensor and storage
    Replaces the old Sensor & Storage draft. Includes the output printed by
    the board and the measured awake time.
2026-10-02 docs: explain the BME280 settings and link their sources
    Forced mode, oversampling and the IIR filter are explained in the A3
    chapter, with the BME280 datasheet (section 3.5) and the
    advancedsettings example of the Adafruit library; the PoC chapter
    links the same sources.
2026-10-02 feat(firmware): A4 part 1, Wi-Fi connection and NTP time sync
    WifiNetwork replaces the skeleton network: it connects to the home
    Wi-Fi with a timeout, reads the time from pool.ntp.org (UTC), and
    turns the radio off afterwards. The Wi-Fi settings live in
    include/secrets.h, ignored by Git and created from secrets.example.h.
    The clock adapter prints the time set by NTP. Rows are not sent yet.
    [Ds3231Clock.h, WifiNetwork.h, main.cpp, secrets.example.h]
2026-10-02 docs(arch): write the A4 chapter on Wi-Fi and time sync
    Replaces the old Network & Time draft. Includes the output printed by
    the board around a full hour and the measured durations.
2026-10-03 feat(firmware): A4 part 2, upload of the rows with the cursor
    The core sends the unsent rows in requests of at most 24 KB (header
    line + complete rows) and moves the cursor only after a 2xx answer.
    SdStorage reads the rows after the cursor and keeps it in /upload.idx;
    WifiNetwork posts them with HTTPClient to kServerUrl (secrets.h).
    New scenarios: rows sent once, server error, large backlog. The demo
    upload period is 5 minutes.
    [SdStorage.h, WifiNetwork.h, main.cpp, secrets.example.h]
2026-10-03 docs(arch): write the A4 upload chapter
    Includes the outputs printed by the board for the first upload and the
    next one, and the test server.
2026-10-03 feat(firmware): A5, maintenance mode with access point and web page
    AccessPointMaintenance replaces the skeleton adapter: an access point
    and a web page to download or delete the measurements, for 3 minutes.
    The page shows the state of the card (size, part not uploaded yet),
    disables the buttons when it is empty, redirects after a deletion and
    counts down the time left. Esp32Power arms the button wake-up (EXT1,
    pin 39). The SD card helpers move to SdCard.h, shared with SdStorage.
    [AccessPointMaintenance.h, Esp32Power.h, SdCard.h, SdStorage.h, main.cpp, secrets.example.h]
2026-10-03 docs(arch): write the A5 chapter, maintenance mode
    With the output printed by the board and two screenshots of the page.
2026-10-04 feat(firmware): A6 part 1, robustness
    - Watchdog: a wake-up longer than 10 minutes restarts the chip.
    - The SD card is mounted once per wake-up (SdCard object shared by the
    storage and the maintenance mode, IStorage::close() before sleeping).
    - The Wi-Fi channel and router of the last connection are reused.
    - The access point is stopped with WiFi.mode(WIFI_OFF) only, which
    removes the netstack error message.
    - Maintenance page: buttons of the same width, firmware version.
    - Firmware version computed by Git (version.py), printed at boot.
    - esp32-bench environment: short periods for the bench; esp32 keeps
    the periods of the design.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
    [AccessPointMaintenance.h, SdCard.h, SdStorage.h, WifiNetwork.h, main.cpp]
2026-10-04 feat(firmware): A6 part 2, log of the wake-ups
    - Console: the adapters print through it, to the serial port and into
    a copy kept in memory during the wake-up.
    - SdStorage::close() appends that copy to /log.txt, dated by the row of
    the wake-up; past 1 MB, the log becomes /log.old.
    - The log is uploaded with the measurements, with its own cursor
    (/log.idx), to POST /api/v1/logs: DataKind selects the file, the
    cursor and the address. kServerUrl is now the server address only.
    - Maintenance page: Download the log button.
    - Two new scenario tests: log sent with the measurements, kept when the
    server refuses.
2026-10-05 feat(backend): add the ingestion server (upload protocol v1)
    FastAPI server storing the measurements in SQLite (timestamp as primary
    key, INSERT OR IGNORE, one transaction per request) and appending the
    log to a text file. A malformed request is refused as a whole. The data
    folder comes from PAWS_DATA_DIR. Managed with uv, tested with pytest.
2026-10-05 feat(backend): add the dashboard
    Dash application mounted in FastAPI under /dashboard/ (a2wsgi), / now
    redirects to it. Last measurement, health of the station (warning after
    2 hours without data), and the graphs of the three quantities over
    24 hours, 7, 30 days or 1 year (daily min, average and max). Moving in
    time by dragging the graphs or with buttons, Ctrl + wheel to zoom,
    dotted line at each midnight, dark and light themes, phone layout.
2026-10-05 perf(backend): make the dashboard fast enough for the server
    On the Raspberry Pi, the 30-day view took 69 s with three years of
    data. The figure is now a plain dictionary (no check of each value by
    plotly.graph_objects), the dotted lines are given at once, SQLite
    converts the times to local time, and the daily summary groups the rows
    by UTC day over the year shown and one year on each side. Measured on
    the server: 0.14 s (24 hours) to 1.25 s (1 year).
2026-10-05 fix(backend): make the made-up data again at each run
    Rows added to an existing database restarted the drift of the pressure,
    which made a jump at the end of the curves.
2026-10-06 feat(backend): add the Compare tab and a free period shown
    Compare tab: a reference and a comparison (day, week, month or year),
    chosen in short lists, drawn over each other from the same left edge,
    dragged and zoomed together. Graphs tab: the period shown has a free
    length and end, set by the period buttons or by the drag and zoom of
    Plotly, stopped at the limits of the data (minallowed, maxallowed). The
    points follow the length shown (rows, hourly or daily values).
    Also: the drag reported the three time axes, so the data was never
    reloaded after a drag; colors checked for color blindness; compact
    layout on a phone, tabs in the header.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
2026-10-07 feat(backend): add the daily backup and the restore
    Every night at 03:30 (systemd timer, made up after a stop), the database
    is copied with the backup function of SQLite, and the log of the
    station; both are compressed, the last 7 days are kept on the server
    and copied to Proton Drive with rclone, where older copies are deleted.
    The Data tab shows the last backup, in red when it failed or is late.
    pixi run backup-backend makes one now; pixi run restore-backend puts
    one back, from the server or from Proton Drive.
2026-10-11 docs(roadmap): move the outdoor station before the forecasting
    The forecasting needs months of real measurements: Phase 6 is now the
    outdoor station (soldered board, enclosure, Stevenson screen, solar
    panel and battery, Wi-Fi range), Phase 7 the data collection, Phase 8
    the basic forecasting. Phase 5 describes the backend as built.
2026-10-11 docs: move the test server and the pull resistors to appendices
    The test server is a bench tool used from Phase 4 to Phase 5: its code
    and addresses move to a Tools appendix. The A4 Upload chapter keeps how
    to start it and set kServerUrl, with a link; A6, the backend chapters
    link to the appendix.
    The theory of pull-up and pull-down resistors (diagrams, equations,
    rules to choose) moves from the Fallback AP chapter to an Electronics
    Notes appendix; the chapter keeps a short explanation and a link.
2026-10-11 docs(outdoor): design the outdoor station and its power
    Phase 6 starts with two chapters, before anything is bought:
    - Design: requirements, XIAO ESP32-S3 on a Grove Shield, storage in
    flash memory instead of an SD card, generic sensor modules (SHT31,
    BMP280, DS3231, INA219) and a waterproof light probe, connections
    with Grove cables and two I2C hubs, the wooden shelter with vent
    grilles and a double roof, and the parts with their prices.
    - Power: what the station consumes, the 18650 battery and the cold,
    the solar panel lying flat, the bq24074 charger and its thermistor,
    and the INA219 battery monitor.
    Three TikZ diagrams (wiring, power, shelter assembly), a photo of the
    bread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
2026-10-11 docs(outdoor): mount the shelter on the garden trellis
    The Wi-Fi signal test found a good signal at the place chosen for the
    station (about -68 dBm, -74 dBm at the weakest): no extra antenna or
    repeater is needed, and step O0 is done.
    The shelter is screwed on an upright of a wooden garden trellis instead
    of a post, above a climbing plant kept at a distance. The height
    requirement now quotes the World Meteorological Organization range,
    1.25 to 2 m.
2026-10-11 docs(outdoor): order the electronics from a single French shop
    The parts list moves to Gotronic, which has the XIAO with its pins
    soldered, the Grove Shield, the bq24074 charger and the light probe.
    The station starts with the BME280 and the DS3231 module of the bench;
    a SHT31 can replace the BME280 later.
    The power chapter follows the parts: a 1000 mAh LiPo battery stuck in
    the box, the SOL3W panel through a DC plug adapter, a common 10 kOhm
    thermistor (charge between about +5 and +44 degrees C, calculated from
    its B constant), and a new Wiring section. The light probe and the reed
    switch connect through Grove screw terminal modules, the INA219 through
    a STEMMA QT to Grove cable. The diagr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
2026-10-12 docs(outdoor): waterproof button, Amazon panel and generic INA219
    The maintenance switch becomes a waterproof push button (IP67), mounted
    through the bottom board of the shelter and pressed from below: no
    magnet, and screw terminals instead of solderings.
    Two parts move to Amazon, for less: a 6 V, 3 W panel whose plug fits
    the charger, so no adapter is needed, and a generic INA219 module, the
    same design as Adafruit's, connected with a Grove to female connectors
    cable. The parts list, the power wiring and the diagrams follow (about
    105 EUR in all).
2026-10-12 docs(outdoor): postpone the light probe to the UV step
    The light probe moves to the later sensors, together with the UV: the
    first outdoor station measures the temperature, the humidity, the
    pressure and its battery. Without the probe, the Grove screw terminal
    modules are no longer needed: the maintenance button connects with two
    jumper wires into a Grove to female connectors cable. The parts list
    follows (about 88 EUR in all), with spare cables for the later sensors.
2026-10-12 docs(outdoor): add a parts list page, shop by shop
    Everything to buy for the outdoor station moves to its own page, in the
    Outdoor Station menu: Gotronic, Amazon, the DIY store, the parts already
    on the bench, and the parts of the later steps (SHT31, LTR390 UV sensor,
    light probe). The design chapter keeps the choice of the shops and the
    total, with a link to the page.
2026-10-12 docs(outdoor): update the prices of the parts list
    The panel costs 16.99 EUR and the JST-PH cables 2.20 EUR each; the coin
    cells move to Amazon, the Gotronic link being gone. The page says why
    there are two Grove hubs, and that the second set of cables can wait
    for the later sensors. About 95 EUR in all.
2026-10-12 docs(outdoor): leave the later sensors to their own steps
    The parts list only lists what the first outdoor station needs. The
    later sensors are chosen in their own steps, which add their parts to
    the list; the page links to their reserved place in the design.
2026-10-12 docs(appendix): explain the DS3231 module and its LED
    A new Electronics Notes appendix describes the common ZS-042 clock
    module: its memory chip, its power LED and how to remove it, its
    charging circuit (harmless at 3.3 V), and its pull-up resistors. The
    design chapter links to it, and the energy of the outdoor station now
    counts the standby current of the DS3231, up to about 110 uA.
2026-10-12 docs(outdoor): list the parts of the bench station too
    The parts list assumed the parts of the breadboard station (BME280,
    DS3231 module, USB-C cable, jumper wires). They are now listed with
    links and prices, for a reader who does not have that station.
2026-10-12 docs(outdoor): two options for the air sensors and the clock
    Starting from scratch, a SHT31 and a BMP280 (Amazon) give a temperature
    about three times more accurate than a BME280, for a similar price; the
    DS3231 module is the common ZS-042 (Gotronic GT584). With the bench
    station, its BME280 and DS3231 module move to the outdoor station. The
    parts list, the design chapter and the wiring diagram show both.
2026-10-12 docs(outdoor): name the battery input of the Grove Shield
    The Grove Shield has no BAT+ and BAT- pins: its battery input is the
    "power bonding pad", two holes 2 mm apart next to its switch. The text
    and the diagrams use this name, and the power chapter asks to check the
    + and the - on the board and its schematic before soldering.
2026-10-12 docs(outdoor): explain the JST-PH connectors of the power wiring
    The power wiring needs three JST-PH connectors besides the battery: two
    cables and one socket, the socket coming with each cable bought. The
    Wiring section now names the plugs and the sockets, gives the male and
    female names of the shops, details the battery side, and asks to check
    the polarity of the battery plug before its first use.
2026-10-16 docs(outdoor): share the alarm cable with the maintenance button
    The D0/D1 Grove connector gives two pins: the yellow wire (D0) goes to
    the alarm of the clock, the white wire (D1) and the black wire (GND) to
    the maintenance button. One Grove to female connectors cable is saved,
    a single set is enough in both options, and the D2/D3 connector becomes
    free. About 91 EUR in all.
2026-10-16 docs(appendix): make the DS3231 module page say what to do
    The page starts with the one change needed, removing the power LED,
    then gives a table of the parts of the module with what to do with
    each (mostly nothing), how to find and remove the LED, and how the
    module connects, its alarm sharing a cable with the maintenance button.
    The reasons come last.
2026-10-16 docs(appendix): show the parts of the DS3231 module on a photo
    A photo of the DS3231 module of the bench station, powered, with each
    part numbered: the LED to remove, its resistor, the charging circuit,
    the resistor networks, the memory chip and the DS3231. The table of the
    appendix follows the numbers.
2026-10-16 docs(arch): show the A6 chapters code from v0.7.0
    The A6 chapters included the current files of the firmware instead of
    those of their release. Renaming the SD adapters for the outdoor
    station would have broken them: they now include v0.7.0, as the other
    chapters of Phase 4 include their own version.
2026-10-16 feat(firmware): keep the rows and the log in the flash memory
    The outdoor station has no SD card: the storage moves to the flash
    memory of the ESP32, with LittleFS, with the same files and upload
    cursors. FlashVolume replaces SdCard (mounting, sizes, cursors), and
    FlashStorage replaces SdStorage.
    When the measurements file is larger than a quarter of the flash and
    the server has acknowledged all its rows, it becomes the previous file
    and a new one starts; the former previous file is deleted. The rule,
    isRotationDue(), is in the core with its tests. The log rotates past an
    eighth of the flash. The maintenance page also offers the previous
    measurements.
    Tested on the bench board: rows stored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
2026-10-16 docs(outdoor): add the flash storage chapter
    The O3 chapter explains the flash memory and LittleFS, the files, how a
    new file starts when the current one is full and sent, why the
    previous file is kept, what happens when the server cannot be reached,
    the rule and its tests, the adapters, the maintenance page, the test on
    the bench board and its troubleshooting. The design chapter describes
    the rotation instead of deleting the oldest rows.
2026-10-16 docs(outdoor): draw every connector of the power wiring
    The power diagram now shows the sockets, the plugs, the solder joints,
    the screw terminals of the INA219 and the lever connector, with a
    legend, and the THERM and GND pins of the charger. The power chapter
    explains what a lever connector is.
2026-10-16 docs(outdoor): explain the THERM jumper, the charge current and the switch
    - The THERM jumper, marked THM, is shown on a photo of the charger,
    with the copper link to cut; the thermistor reaches the charger
    through two wires of 15 to 20 cm.
    - The charger charges at 1 A as delivered; the panel limits the
    current to about 0.5 A, so the battery is charged by the panel only.
    - The power switch of the Grove Shield is ON outdoors.
2026-10-16 docs(outdoor): mount the modules in the sealed box
    - One M3 screw for the BME280, which has a single mounting hole.
    - The modules and the battery are stuck with double-sided tape, the
    charger a few centimetres away from the battery; they need no air.
    - The cable entries are sealed by small holes in the membranes and a
    drip loop, without self-amalgamating tape.
2026-10-16 docs(outdoor): complete the DIY store list
    Add the multimeter, the Wago 221 lever connectors, the heat-shrink
    tubing, the double-sided tape and the wood screws; one M3 screw only;
    drop the self-amalgamating tape and the silica gel, kept from a box.
2026-10-16 docs(appendix): explain the THERM jumper of the bq24074 charger
    The THERM jumper connects the THERM pin to the ground through a fixed
    10 kΩ resistor, not directly: the charger then believes the battery is
    at 25 °C. The new appendix explains why the jumper is cut before the
    thermistor is soldered (in parallel, the charger would see 31 °C in the
    frost), how to cut it, and how to check it with the resistance range of
    a multimeter, with the readings of our board. The power chapter keeps a
    short summary and links to it.
2026-10-18 feat(tools): add a bench check program for the XIAO
    Every two seconds, it lists the modules that answer on the I2C bus, with
    their name, and the state of the maintenance button (D1, internal
    pull-up) and of the clock alarm (D0). pixi run bench-check flashes it
    and opens the serial monitor.
2026-10-18 docs(outdoor): draw the ground wire of the maintenance button
    The button gets the white (D1) and the black (GND) wires of the D0/D1
    cable: the diagram now draws both, and names the yellow wire of the
    alarm. Also fix the × of the DC plug size.
2026-10-18 docs(outdoor): add the O2 bench chapter and an O3 firmware section
    - O2 · Bench: the modules on the desk, the colors of the Grove cables,
    the power rules, and the check of the wiring with its output.
    - New appendix: Bench Check, in Tools.
    - The flash storage chapter becomes the first page of an O3 – Firmware
    section (04-1-flash-storage.qmd); its old address redirects to it.
    - The design chapter gives the Grove colors and links the O2 and O3
    steps from its implementation plan.
2026-10-18 feat(firmware): run the station on the XIAO ESP32-S3
    - xiao and xiao-bench environments; `pio run` builds both boards.
    - Board.h gathers the pins of each board: alarm on D0, button on D1
    (active low, internal pull-up) for the XIAO; 36 and 39 for the uPesy.
    - The power adapter arms the button from Board.h; on the XIAO, the
    internal pull-up stays on in deep sleep through the RTC peripherals.
    - Partition table of the XIAO: 3 MB for the firmware, about 4.9 MB for
    the files.
    - On the native USB port of the XIAO, Serial.flush() waits forever when
    no computer reads the port: it is no longer called before the deep
    sleep, which kept the station awake.
    - The serial monitor of the xiao enviro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
2026-10-18 docs(outdoor): add the O3 chapter on the XIAO
    The XIAO chapter covers the environments, Board.h, the partition
    table, the wake-up by the alarm and the button, the native USB port
    (port name, DTR, Serial.flush()) and the output of the bench. The flash
    storage chapter gives the size of the XIAO partition. The bench check
    monitor sets DTR as well.
2026-10-30 feat(backend): reorganize the dashboard around a navigation panel
    The dashboard was hard to navigate: the period shown was not written
    anywhere, and the cards, the buttons and the icons of Plotly crowded
    the graphs.
    - A navigation panel holds the tabs: on the left on a computer, as a
    bar at the bottom of the screen on a phone.
    - A new tab, Now, opened first: today's date, the health of the
    station, and for each quantity its last value, its change over 3
    hours, a small curve of the last day, and the minimum and maximum
    of the day with their times.
    - The Graphs tab: arrows move by one period, and the period shown is
    written between them ("Thu 29 Oct, 14:52 → now"). Dragging and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
2026-10-30 feat(backend): tell what the trends mean in the Now tab
    A short text at the top of the Now tab tells what the changes of the
    last 3 hours mean. The pressure follows the scale of the weather
    services (UK Met Office): steady below 0.1 hPa, then slowly, normally,
    quickly and very quickly, each with what a rise or a fall often brings.
    The temperature and the humidity are only mentioned when they change
    clearly (1 °C, 10 % in 3 hours).
2026-10-30 feat(backend): show the dew point, the feels-like and the sea-level pressure
    The dashboard computes three quantities from the measurements, on the
    server (weather.py):
    - the dew point, with the Magnus formula;
    - the feels-like temperature in the heat (heat index of the US weather
    service), above 27 °C and 40 % of humidity only: in the cold, it
    depends on the wind, which the station does not measure;
    - the pressure at sea level, from the altitude of the station given by
    PAWS_ALTITUDE_M (140 m for Beauzelle in the service file).
    SQLite calls these functions in the queries, so that the daily
    minimums, averages and maximums are computed from each row, and the
    past measurements get them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
2026-10-30 feat(backend): write the dashboard in French and explain the values
    The dashboard is now in French: tabs, buttons, cards, sentences,
    messages of the Data tab and of the uploads. Dates use French names
    and order, written by french_date() instead of the system locale, and
    given to Plotly as its "fr" locale for the axes and the values under
    the mouse; numbers use a decimal comma.
    The Now tab explains how to read the values: four blocks, closed until
    clicked (pressure and its trend, dew point, relative humidity,
    feels-like temperature). The temperature card tells what the dew point
    means for comfort ("air sec", "un peu lourd"...).
    The book and the code stay in English.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
2026-10-30 docs(appendix): check the panel and the battery with a multimeter
    A new appendix in Tools explains how to connect a multimeter for each
    check of the power, with a diagram for each one:
    - the voltage of the battery, on the LIPO and GND pads of the charger;
    - the voltage of the panel, on its plug;
    - the short-circuit current of the panel, on the 10 A range;
    - the current that charges the battery, with the multimeter in series
    between two DC adapters.
    It explains the voltmeter (in parallel) and the ammeter (in series),
    why an ammeter across the battery is a short circuit, and the two
    rules that prevent it. A table tells what each reading means.
    The power chapter links to it.
    Co-Authored-B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
2026-10-30 fix(backend): write the temperature title on two lines
    The title of the temperature graph, with the dew point and the
    feels-like temperature, was too long to read on one line. The name of
    the graph stays on the first line; the computed quantities go on a
    second line, in smaller letters, in their colors. The dates under the
    time axis are shorter ("ven. 30"), so that they no longer touch on a
    phone.
2026-10-30 feat(backend): add the absolute humidity, the vapour deficit and advice
    Two more quantities computed from the temperature and the humidity
    (weather.py), returned by the queries like the dew point:
    - the absolute humidity, in g/m³: the real amount of water in the air,
    which tells whether airing the house dries it;
    - the vapour pressure deficit, in kPa: how fast the air dries plants,
    soil and laundry.
    Both are written on the humidity card of the Now tab, the deficit with
    how fast the air dries. Below the summary, two pieces of advice:
    - watering, from the highest deficit of the last day, with a warning
    that the soil and the rain are not measured;
    - laundry, from the rain announced by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
2026-11-01 feat(backend): redesign the Now tab for the phone
    The Now tab showed the date on two lines and two blocks of text before
    the temperature, and its small curves, drawn by Plotly, were redrawn
    badly when the tab was shown again.
    - At the top, on one card: the day and the time of the last
    measurement, the temperature in large, its dew point, its change and
    the extremes of the day, its curve, then the summary of the weather.
    - Below, tiles: humidity and pressure, each with its value, change,
    curve, other values and extremes; then laundry and watering, each
    with a short headline ("Séchage lent") and its detail.
    - The small curves are SVG images written by the server: no Plotly
    in the t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
2026-11-01 feat(backend): add the forecast, frost, sun and moon to the Now tab
    What usual weather apps give, computed on the server without any new
    sensor:
    - the forecast of the barometer (Zambretti method, weather.py), from
    the pressure at sea level and its trend over 3 hours, shown first in
    the summary;
    - the temperature against yesterday at the same time, from the row
    closest to 24 hours before (database.row_near());
    - a frost tile, only when it freezes, or at night when the air is
    close to 0 °C or dry and cool;
    - a sun and moon tile (sky.py): sunrise and sunset with the sunrise
    equation, the length of the day and its change since yesterday, the
    phase and the light of the moon. The pos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
2026-11-11 feat(backend): give the laundry and watering advice for the hour
    The advice looked only at the air: at night it could say the laundry
    dries well. It now also follows the sun of the day: no drying at night,
    hang out 2 hours after sunrise once the dew is gone, bring in an hour
    before sunset; water in the morning or the evening, and wait for the
    evening in the heat of the day.
2026-11-11 feat(backend): add the clothes and running tiles
    Two tiles of the Now tab tell what to wear: the clothes for the
    temperature felt, a cap in the sun of a warm day, an umbrella when the
    barometer announces rain; for running, the clothes for 10 °C more, a
    warning in the heat and a light at night. The help explains the rules.
2026-11-11 feat(backend): zoom the graphs with buttons
    A phone cannot zoom the graphs with two fingers: Plotly only moves them.
    Two buttons now halve or double the period shown, around its middle,
    between 3 hours and 2 years. The arrows use Lucide icons too.
2026-11-14 docs(outdoor): add the O4 shelter and O5 outdoors chapters
    O4 shows the shelter as built and its differences from the plan (bare
    wood, BME280 without spacers), with a photo of the station on its
    trellis. O5 empties the database, switches the station on, and checks
    it with the dashboard, the maintenance button and the log.
